otitbridge/snes-controller-uiapduino/docs/development/README.md

# 開発記録

ここでは試行履歴・原因調査・作業引き継ぎを扱います。導入や通常使用は [利用者向け資料](../publication.md) を参照してください。

## 開発中の追加機能（2026-11-12）

`feature/select-boot-keymap` で起動時SELECTによるTab／Backspace切り替えを実装しました。[動作仕様](../sfc-keyboard.md#起動時selectによる切り替え開発版)と[ビルド結果](../build.md#開発ブランチの追加機能)を参照してください。2026-11-13に実機書き込みと読み戻し検証を完了し、ユーザーから動作に問題なしとの報告を受けました。公開済みv1.0.0は変更していません。

## 保存した履歴

2026-11-10、公開資料と備忘メモを分けるため、コミット `7de5b1e` 時点の以下の文書を保存しました。本文は相対リンクの調整を除いて維持しています。「現在」「次工程」「未実施」は保存当時の表現で、最新状態の案内ではありません。

| 記録 | 内容 |
| --- | --- |
| [検証履歴](validation-history.md) | ホスト試験、書き込み、実機操作、再試験の時系列 |
| [問題調査の履歴](known-issues-history.md) | U04・D09・SELECT、原因候補、観測方法と判断の限界 |
| [統合版の履歴](sfc-keyboard-history.md) | 入力とUSBの統合、Mac／iPhone試験、ファーム切り替え |
| [ビルドの履歴](build-history.md) | 旧モードのサイズ、依存物照合、書き込み・取得方法 |
| [配線と診断の履歴](wiring-history.md) | 線色照合、誤配線訂正、未接続・実配線の診断結果 |

この編集は試験の再実施や不具合の修正ではありません。既存JSONと過去の文書ハッシュは当時の証跡として保持します。

## その他の開発資料

- [開発環境と参照元の来歴](../provenance.md)
- [最小HID試験の記録](../minimal-hid.md)
- [証跡JSONの索引](../evidence/README.md)
- [コアの管理パッチ](../../patches/README.md)
- [引き継ぎ仕様と作業計画](../../SNES_UIAPduino_CODEX_HANDOFF.md)

## 作業再開時の前提

| 項目 | 現在の状態・参照先 |
| --- | --- |
| 通常版 | SELECT→Tabの `sfc-keyboard`。BINの識別は [ビルド資料](../build.md#成果物を確認する) |
| 内蔵構成 | 元ケーブルを撤去し、USB-Cケーブル接続状態で収納。入力・再接続・30分使用・握り込み・ケーブル軽操作は確認済み。[証跡](../evidence/enclosure-fit-2026-11-11.json) |
| iPad | Air（M2）／iPadOS 26.5／Delta 2.0.1で動作確認済み。[確認範囲](../validation.md#ipadでの確認) |
| U04・D09 | ユーザー裁定で未解決のまま許容。追加の原因調査は次工程の前提にしない |
| Backspace | Delta 2.0.1でも再現報告あり。[Issue #579](https://github.com/rileytestut/Delta/issues/579) へ投稿済み。Tabを維持 |
| 残る試験 | SNES実ゲーム、Deltaでの6／7入力、SNESの右＋Y＋B部分解放。詳細は [未確認の範囲](../known-issues.md#未確認の範囲) |
| 写真 | [内部配置・完成外観](../hardware.md#内蔵用部材と写真) を収録済み |
| 未収録の資料 | SFC基板接続点の接写、施工寸法・固定方法、電気的な実測、再書き込みアクセスの確認 |

通常版の合意した試験範囲は完了しています。内蔵後とiPadの個別試験条件が未記録の部分は、過去の測定値や別端末の条件で補完しません。Backspace再現試験とiPad動作確認も別の報告です。

## 追加の調査

- [Delta 2.0.1のBackspace入力調査](delta-keyboard-review.md)：公開ソース比較と再現報告。1.7.3の詳細比較・2.0.1の追加報告・原因仮説を区別しています。
- [USBケーブル直付けと代替CH32ボード](usb-direct-wiring.md)：D+／D−の引き出し、回路図の参照先、移植・加工時の確認点。

公開操作はユーザーの指示に従います。文書更新・ローカルコミット・push・リリースはそれぞれ別の作業として扱います。
