otitbridge/snes-controller-uiapduino/SNES_UIAPduino_CODEX_HANDOFF.md

# SFCコントローラー内蔵UIAPduino版 — Codex引き継ぎ・実装検証計画

- 作成日：2026-11-10（日本時間）
- 所有者：otitbridge
- 文書の位置づけ：実装前の引き継ぎ仕様・検証計画。完成版READMEではない。
- リポジトリ：<https://github.com/otitbridge/snes-controller-uiapduino>
- 既存プロジェクト：<https://github.com/otitbridge/snes-controller-m5stick-s3>

> **今回の開発は、すでに動作しているM5StickS3版の小型化・コントローラー内蔵化である。**
> SFC入力読み取りとHIDキー変換を再利用し、USB実装をUIAPduino／CH32V003向けに置き換える。
> M5StickS3版の成功は、UIAPduino版の成功を保証するものではない。ソフトウェアUSB、電圧、ピン、接続・復帰処理は移植先で検証する。

> 本文には実装開始時の計画・初期状態を残しています。作業を再開する際は [開発記録の現在状態](docs/development/README.md#作業再開時の前提)、[検証結果](docs/validation.md)、[既知の問題](docs/known-issues.md) を先に確認してください。「最初に実行すること」や初期試験表を、完了済み作業の再実施指示として扱わないでください。

## 0. Codexが最初に実行すること

2026-11-11追記：[USB HID・DirectInput・XInputの公開実装調査](docs/development/gamepad-windows-research.md) をmainの開発資料に保存しました。キーボード版を合意した確認範囲での完成品として維持し、`feature/usb-gamepad` の実験は保留を継続します。Windows 11での試験は未実施で、以下の初期計画をゲームパッド開発の再開指示として扱わないでください。

1. この文書を読み、作業ディレクトリ、既存ファイル、Gitの変更状態、利用可能なビルド環境を確認する。
2. 既存M5StickS3リポジトリと本書の参照コミットを読み取り専用の比較対象として確認する。既存版をUIAPduino用に上書きしない。
3. 新規作業領域で、SFC入力・HIDレポート生成・USBバックエンドを分離した最小構成を用意する。
4. 最初はホスト上の純粋ロジックテストと最小HIDファームウェアのビルドまで進める。ボードの型番・接続対象・書き込み手段が未確認なら、実機への書き込みは行わない。
5. 実機検証の結果が得られたら、本書の検証表を転記した記録に「条件・手順・結果・証拠」を追記する。

**すでに決まっている方針を再質問しないこと。** 不明なピンや機種は未確定として設定・記録に分離し、その情報がなくてもできるコード整理とテストを先に進める。ただし、通電・書き込みに必要な情報を推測で埋めない。

## 1. ゴールと利用シーン

```text
SFC／SNES純正コントローラーのボタン
    ↓ 既存コントローラー基板のシリアル出力
筐体内に収納したUIAPduino開発ボード（CH32V003）
    ↓ USB HIDキーボード／有線USB-C
USB-C搭載iPhoneまたはiPad
    ↓ キー割り当て
Delta
    ↓
レトロゲームの操作
```

利用時にPC、外付け変換器、Bluetoothペアリングを必要としない構成を目指す。開発・書き込み・診断のためのPC使用は問題ない。

完成後はGitHubとProtoPediaで公開し、ニコニコ技術部系の展示会で体験展示する予定。訴求点は「純正の操作感・外観をできるだけ維持し、小型開発ボードを内蔵してiPhone／iPadへ有線接続する」こと。世界初などの新規性は未検証であり、主張しない。

## 2. 確認済み事実と未検証事項

### 2.1 ユーザー本人が確認・決定していること

| 項目 | 状態・意味 |
| --- | --- |
| M5StickS3版は本人のプロジェクト | `otitbridge/snes-controller-m5stick-s3` |
| M5StickS3 → USB-C有線 → iPhone 17 → Delta | 本人が実機動作確認済みと報告している |
| UIAPduino開発ボードの筐体収納 | 開発ボードをそのままSFCコントローラー内に完全収納し、配線する具体的な算段がある |
| 検証の順番 | 筐体内へ組み込む前に、ブレッドボードで長押し・同時押し等を確認する |
| 今後の開発 | Codexへ引き継いで実装・検証する |
| 公開先 | GitHub、ProtoPedia |
| 所有UIAPduinoの版数 | V1.4（2026-11-10、本人申告） |
| 所有UIAPduinoの電圧設定 | 5V、初期状態（2026-11-10、本人申告。実測値ではない） |

「収納の算段がある」は「内蔵完成品が動作確認済み」と同義ではない。外付けアダプター方式へ方針を戻す必要はない。

### 2.2 既存リポジトリから確認できること

既存READMEには、iPhone 17／iOS 26.6.2／Delta 1.7.3sで、USB接続したM5StickS3が外付けキーボードとして認識された記録がある。日付は2026-10-12。これは既存版の記録であり、新版の検証結果ではない。[S1]

コードには、SFCの16ビット読み取り、12ボタンのビットマスク化、6キーのHIDレポート生成、接続時の状態同期・送信失敗時の再試行、およびそれらのホスト上の回帰テストがある。[S2][S3][S4]

### 2.3 まだ確認されていないこと

- UIAPduino版でのSNES実ゲームの全12入力。SNESのキー配置画面は旧版で全12入力を確認済み。iPad Air（M2）／iPadOS 26.5／Delta 2.0.1でも動作確認済みとの本人報告があり、個別試験条件は未記録。iPhone 17／iOS 26.2／Delta 1.7.3のGBA『シナモンふわふわ大作戦』では、10入力登録とゲームで使う操作の成功を本人が報告済み。USB列挙の詳細は取得していない。
- UIAPduino版のUSBキーボード出力での短押し保証、起動時保持、再接続・復帰の安定性。Macでは全12ボタン・左右の30秒以上の保持・同時押し・部分解放・6→7→6入力の復帰を確認済み。iPhone／DeltaのGBAでは全解放での再接続10回・USB-Cの向き4組・抜去中の右解放は本人報告で成功したが、接続前から保持した右は押し直しが必要でU04は未合格。U04・D09は未解決のまま許容するユーザー裁定があり、追加調査を作業継続の条件にはしない。
- 所有するUIAPduinoの正式な製品型番、実測VDD、ブートローダ全体の照合。版数V1.4・電圧設定5V（初期状態）は本人申告済み。導入コア1.2.15とブートローダ記述子1.41はP2で確認済み。
- 使用するSFCコントローラーの型番・基板版、実測電源と信号波形。既存版と同じ個体で、基板番号・線色・5信号の対応は本人申告済み（`docs/wiring.md`）。実配線修正後の入力診断は確認済み。写真・導通の元記録は未保存。
- 検証用iPadの個別試験条件。機種はiPad Air（M2）、OSはiPadOS 26.5、Deltaは2.0.1と報告済み。iPhoneの全試験結果をiPadへ転用しない。
- 内蔵の施工詳細、発熱の個別結果。内蔵後の30分連続使用、握り込み・ケーブル軽操作時の安定性は本人報告で問題なし。絶縁・固定・挟み込み・干渉、閉蓋後の操作感、入力・接続確認は本人報告で問題なし。

**この文書の作成時には、UIAPduino用ファームウェアのビルド、書き込み、実機試験は行っていない。** 過去の会話で紹介された第三者のiPhone接続事例は補助情報にとどめ、このプロジェクトの合格証拠にしない。

## 3. 今回の範囲

### 必須

- UIAPduino開発ボードを使用し、SFCコントローラー筐体へ内蔵する。
- 既存コントローラー基板のCLOCK／LATCH／DATA方式を使う。
- USB HIDの**キーボード**として動作させる。USBゲームパッド化は初期目標にしない。
- 十字キー、A／B／X／Y、L／R、START／SELECTの12入力を読み取る。
- 初期版では既存M5StickS3版と同じキー割り当て・6キー同時押し方針を採用する。
- キーの押下状態を保持し、離したキーを確実に解放する。
- iPhone 17を優先して検証し、iPadは端末別に追加検証する。
- 再現可能なビルド方法、配線、書き込み方法、検証条件を記録する。

### 初期版では対象外

BLE、Wi-Fi、LCD、Webモニター、Webゲーム、OTA、マクロ・連射、NKRO化、独自PCB設計、汎用設定アプリ、他機種コントローラー対応。

既存のGBA Dumperとの展示連携は将来の演出案であり、本件の実装依存にはしない。

## 4. 参照ソースと固定点

2026-11-10に確認した参照先は以下。再現性のため、`main`だけでなくコミットSHAを記録する。

| 対象 | 参照点 | 用途 |
| --- | --- | --- |
| 既存M5StickS3版 | `21b7ba91c6428b25d7b7ab116052443a9aced965` | 入力読み取り・キー変換・テスト・既存実績 |
| `tarosay/arduino_core_ch32` | `9471a150c9837c9055ef62ef759a1a593eddf1b1` | UIAPduino向けArduinoコア候補の実装確認 |
| `tarosay/board_manager_files`のパッケージ索引 | 確認時に`UIAP_HID:ch32v`の`1.2.15`が掲載 | 導入候補。実際の導入版・取得物を記録する |
| UIAP公式V1.4ページ | 作成日に確認した公開資料 | 電圧、ボード仕様、回路資料への入口 |

`tarosay`のコアは採用候補であり、メーカーが提供するすべての環境と同一ではない。別forkのピン番号、API、USB設定を混在させない。パッケージ版と確認済みGitコミットの同一性も、実装開始時に照合する。[S5][S6][S7][S10]

## 5. 再利用する部分・置き換える部分

| 既存資産 | 方針 |
| --- | --- |
| `src/main.cpp`の`readController()` | 読み取り順・極性・タイミングを参照して切り出す。GPIOと環境依存部分を変更 |
| 12ボタンのビット定義 | 維持 |
| `src/keyboard_state.h`の`Report`と`makeReport()` | 優先して再利用。名前空間は衝突回避のため変更推奨 |
| 同ファイルの`State` | 設計意図とテスト観点を再利用。USB送信契約が違うため無条件に流用しない |
| `tests/usb-keyboard-state.test.cpp` | 既存挙動の仕様資料として利用。純粋レポート生成と移植先USBのテストを分離 |
| `USB.h`、`USBHIDKeyboard.h`、TinyUSB呼び出し | UIAPduino用バックエンドへ置換 |
| ESP32のUSBイベント、`std::atomic`、タスク前提 | 移植先のイベント・割り込み設計に置換 |
| M5Unified、LCD、BLE、Wi-Fi、Web機能 | 新版には持ち込まない |
| `platformio.ini` | ESP32用設定をコピーしない。新しい環境で独立して定義する |

根拠：既存コードとテスト。[S2][S3][S4]

## 6. 入力仕様・キー割り当て

### 6.1 ビットマスク

内部状態は`uint16_t`の下位12ビットを使用し、`1 = 押下`とする。SFCのDATA信号ではLOWが押下であり、読み取り時に内部表現へ変換する。[S2]

| bit | SFCボタン | キー | Raw HID Usage ID |
| ---: | --- | --- | --- |
| 0 | B | Z | `0x1D` |
| 1 | Y | A | `0x04` |
| 2 | SELECT | Tab | `0x2B` |
| 3 | START | Enter | `0x28` |
| 4 | UP | 上矢印 | `0x52` |
| 5 | DOWN | 下矢印 | `0x51` |
| 6 | LEFT | 左矢印 | `0x50` |
| 7 | RIGHT | 右矢印 | `0x4F` |
| 8 | A | X | `0x1B` |
| 9 | X | S | `0x16` |
| 10 | L | Q | `0x14` |
| 11 | R | W | `0x1A` |

表の英字はキーの名称であり、大文字入力のためのShiftを追加する意味ではない。初期版の修飾キーバイトは常に0とする。Raw HID Usage IDと、ASCIIコードやArduinoの`KEY_*`定数は区別する。[S3][S8]

SELECTはP4のDelta 1.7.3でBackspaceが割り当て画面に受け付けられない問題への対処候補として、ソースをTabへ変更しました。旧版はBackspace（`0x2A`）です。22:19に候補を書き込み、読み戻し・起動を確認しました。MacのTab押下・解放とDeltaのTab登録・GBA動作は確認済みで、現在搭載中のBINはP4証跡の `current_device_firmware` を参照してください。使用する各システムのDeltaキーレイアウトでSELECTをTabへ設定します。GBAでは再割り当てと動作確認が完了しています。

### 6.2 レポート生成

- `modifiers` 1バイト、`reserved` 1バイト、`keys[6]`で8バイト。
- `reserved = 0`。未使用キー枠は0で埋める。
- 押下中の全ボタン状態から、その時点のレポートを作る。
- 7キー以上なら、上記bit順の先頭6キーを採用する。
- 6キー以内へ戻ったときは、まだ押されているキーを再計算して反映する。
- 初期版で7キー以上を完全に扱えるとは宣伝しない。12入力の読み取り対応と6キー同時出力は別である。

これは既存版の仕様を維持するための選択であり、USBキーボード全般の最大値を意味しない。[S3]

### 6.3 SFC読み取りの初期基準

既存版は、CLOCKをHIGHにし、LATCHをHIGHで12µs保持、LOWにして6µs待機した後、最初のビットを読み取る。その後、CLOCKのLOW／HIGHを各6µsとして計16ビットを読み、`0x0FFF`でマスクする。入力ポーリングは約10ms間隔。[S2]

初期移植ではこの挙動を基準にする。ただし、これは**既存コードの設定値**であり、移植先の実測値でも、ゲーム画面までの遅延でもない。USB割り込みによる波形の伸びや、`delayMicroseconds()`の実装差は必要に応じて測定する。

## 7. ハードウェア確認

### 7.1 ボードと電圧

所有ボードは**V1.4、電圧設定5V（初期状態）**と2026-11-10に本人から報告された。正式な製品型番と実測電圧は未確認。本書の具体的なピン候補は**UIAPduino Pro Micro CH32V003 V1.4**を想定しており、採用前に実物との対応を確認する。

メーカーのV1.4資料では、MCU電源は5Vが初期値で、3.3Vへの切り替えが可能。また、MCU電源の設定を変えても、3.3V出力ピンと5V出力ピンの意味は変わらない。[S10]

初期試験ではMCUとSFCコントローラーの電圧系統を明確にし、可能なら同じ電圧に揃える。5V構成と3.3V構成のどちらを使うかは、実物の設定とコントローラーの動作を確認して決定する。既存M5StickS3版は3.3V給電だが、それを電源ピン名だけで移植しない。[S1]

通電前に次を確認する。

- MCUのVDD、コントローラーのVCC、CLOCK／LATCH／DATAの電圧整合。
- USB給電と外部給電を不用意に並列接続しない構成。
- 共通GNDと、電源・GND間の意図しない短絡がないこと。
- ケーブル色だけで信号を断定せず、導通で接続点を特定したこと。
- M5StickS3とUIAPduinoで同じCLOCK／LATCHを同時に駆動しないこと。

### 7.2 ピンの予約と候補

確認したコアではPC4／PD2をUSB-CのCC制御に使用している。PD3／PD4もUSB用である。これらをSFC用GPIOに流用しない。PD1はSWIOに関係するため、初期版では復旧性のために避ける。[S6][S7]

| 用途 | MCUポート候補 | 確認したコアでのArduino番号 | 状態 |
| --- | --- | --- | --- |
| SFC CLOCK | PC5 | `GPIO_PIN_7` | P3診断版で採用、実配線後の入力を確認 |
| SFC LATCH | PC6 | `GPIO_PIN_8` | P3診断版で採用、実配線後の入力を確認 |
| SFC DATA | PC7 | `GPIO_PIN_9` | P3診断版で採用、実配線後の入力を確認 |

ポート対応はコアREADMEによる。[S5] 採用前に実際の`variants`、基板シルク、ピンの兼用機能を照合する。裸の整数値は物理ピン番号と混同しやすいため、設定にポート名も併記する。

SFC基板への電源・GND・3信号の接続点、採用電圧、ケーブル引き出し方法は`docs/wiring.md`に写真とともに記録する。USB配線を加工する場合はCC線とD+/D-を含めて確認し、既存コネクタ経路での成功と加工後の成功を分ける。

2026-11-10に本人から提示されたSFC基板の接続番号は、1＝茶/GND、2＝赤/DATA、3＝橙/LATCH、4＝黄/CLOCK、5＝白/VCC。この個体の本人申告として扱い、外部7ピンコネクターの番号やUIAPduinoの表示番号と区別する。対応表とネット上の資料との比較は `docs/wiring.md` に記録済み。同日に本人が実配線の相違を修正した後、全12ボタン・左右の長押し・同時押し・部分解放を診断で確認した。写真、導通・電圧の元記録は未保存。

### 7.3 内蔵時の確認

収納自体の算段はユーザーが済ませている。設計をやり直すのではなく、絶縁、固定、ケーブルの引張り対策、ボタン／ゴム接点／ねじとの干渉、書き込みモードへのアクセスを確認する。ブレッドボード版の合格後に内蔵し、内蔵後に再試験する。

## 8. ビルド環境の方針

第一候補は、確認した`tarosay/arduino_core_ch32`を使うArduino環境。USBモードは`Keyboard+Mouse`を基準にする。マウス機能は使用しないが、初回からディスクリプタを大幅に改造しない。[S5]

確認時のパッケージ索引には`UIAP_HID:ch32v`の`1.2.15`と、`HID ProMicro CH32V003`というボード名が掲載されている。[S7]

```text
追加ボードマネージャURL：
https://github.com/tarosay/board_manager_files/raw/main/package_uiap_hid_index.json
```

Codexはインストール済み環境を調べ、実際のFQBN、USBモードのオプション、アップロード方式を取得してからコマンドを確定する。存在を確認していないFQBNやシリアルポートを推測して書き込まない。

記録対象：OS／CPU、Arduino IDEまたはCLIの版、コアの版、ソースSHA、ツールチェーン、ビルドオプション、USBモード、使用アップローダ、バイナリサイズ、Flash／RAM使用量、ブートローダを除いた利用可能領域。

CH32V003の公称Flash 16KB／RAM 2KBを、アプリが無条件で全量使えるという意味にしない。ブートローダ予約領域、スタック、USB内部バッファを含む実際のビルド結果を確認する。[S5]

既存版がPlatformIOだからという理由で、初回からPlatformIO対応を優先しない。必要なら最小ファームの成功後に追加する。ch32fun／rv003usbの直接利用は代替案とし、初回から複数のUSB実装を並行開発しない。

## 9. USB実装で必ず扱う注意点

### 9.1 バッファ更新と送信成功は別

確認した`uiapkbd_keyboard_set()`は、8バイトのキーボード状態バッファを書き換える`void`関数である。USBのIN要求を扱う割り込み側が、そのバッファを参照して送信する。[S6]

一方、既存`Keyboard::State::update()`は、渡された送信関数の`true`を受けて、送信済み状態や同期状態を進める設計である。[S3]

**したがって、setterを呼んだ直後に無条件で`true`を返すだけでは、既存Stateの送信契約を維持できない。** また、送信APIの成功が何を意味するかは、キュー投入・転送完了・ホスト受信を区別して確認する。どの段階もDeltaのゲーム操作反映とは別である。

最小試作は「最新レポートを保持する」方式でよい。ただし、復帰時のニュートラルレポートや短押しを保証するには、ホストが取得する前の上書き、接続状態、送信タイミングを別途扱う。

`desired`（現在必要な状態）、`staged`（USB側へ渡した状態）、`transferred`（確認できる範囲の転送状態）など、変数名にも意味を分ける。観測できない完了状態を推測で作らない。

### 9.2 `Keyboard`という名前の衝突

既存ヘッダは`namespace Keyboard`を定義する。UIAPduino側の`Keyboard.h`はグローバルな`Keyboard`オブジェクトを宣言するため、両者を同じ名前のまま同一翻訳単位へ持ち込むと衝突する。[S3][S8]

推奨する回避策：移植する純粋ロジックの名前空間を`SnesHid`等へ変更し、USBバックエンドでは必要な`uiapusb.h`だけを使用する。`Keyboard.h`が実際に必要なときだけ追加する。

### 9.3 まずは状態全体からレポートを生成する

長押しを`Keyboard.write()`の繰り返しで実現しない。確認した実装では`write()`は押下・待機・全解放・待機を行い、既存の保持キーもクリアするため、ゲーム操作の長押し・同時押し用途にはそのまま使えない。[S9]

また、確認した`press()`には同じキーの登録済みチェックが見当たらず、押されている間に毎ループ呼ぶと同じキーで枠を埋める可能性がある。[S9]

既存の`makeReport()`を基に、現在の12ビット状態から一つのレポートを作る方式を優先する。毎回「全解放 → 押下」を送る実装も避け、保持中のキーを不必要に離さない。

### 9.4 共有バッファの整合性は検証対象

確認したコアではメイン側が`volatile`のバッファを1バイトずつ更新し、USB割り込み側が同じバッファを参照する。setter内に、8バイト全体を一括で公開する仕組みは見当たらない。[S6]

**解析上の懸念：更新途中に割り込みが入ると、新旧状態が混じる可能性がある。** これは今回実機で確認した不具合ではない。必要に応じて二重バッファと短い公開操作等を検討し、採用実装と割り込み処理を追って確かめる。

USBがソフトウェア処理であるため、対策として長い割り込み禁止区間を安易に作らない。特にSFCの16ビット読み取り全体を`noInterrupts()`で囲まない。コア側を変更する場合はパッチを管理し、導入済みパッケージを黙って手編集しない。

P3の `sfc-keyboard` では専用コピーへ管理パッチを適用し、2つの8バイト配列と1バイトの公開索引で完成状態を公開する実装を追加した。元コアは保持し、ホストの割り込みモデルで混在の再現・解消を確認した。割り込み禁止は追加していない。実装・前提は `patches/README.md`、実施状態は `docs/sfc-keyboard.md` を参照する。転送完了や短押し保持の保証とは区別する。P4ではGET_REPORT(Input)応答を加えた候補を検査・書き込みしたが、Macの接続時保持は物理保持中にkeyupとなり、U04は未合格のまま。基板のキーボード状態とホストイベントを切り分ける。

### 9.5 短押しと復帰は、単なる最終状態確認では不十分

ホストが次に取得する前に「押す → 離す」が発生すると、最終状態だけのバッファでは押下を取りこぼす可能性がある。また、ニュートラルを設定して直後に押下状態へ上書きすると、ホストがニュートラルを受け取ったとは限らない。[S6]

初期版は最新状態方式で動かし、実際の操作で短押しと復帰を測定する。問題が出た場合に、必要な状態遷移の保持や送信完了に対応した処理を追加する。無制限のイベントキューや固定の長い待機で隠蔽しない。キューを使うなら、満杯時の方針と「解放を失わない」条件を定義する。

### 9.6 Report ID・USBモード・割り込み

既存M5StickS3版のReport IDを、UIAPduinoの8バイトデータへそのまま付け足さない。採用するディスクリプタと送信関数の形式に合わせる。確認したコアのキーボード経路は8バイトを送っている。[S2][S6]

`WebHID Only`は標準キーボード出力と同じではない。Keyboard用APIが使えるビルドモードを選択する。[S5]

コアにはUSBのタイミングを守るためSysTick割り込みを使わない実装上の説明がある。汎用タイマー割り込みや別ライブラリの割り込みを追加する際は、USB動作への影響を確認する。[S6]

### 9.7 移植の概念例 — 完成ファームウェアではない

```cpp
// SnesHid::Report / makeReport() は既存ロジックを改名して切り出す想定。
// GPIO初期化、USB初期化、接続・復帰管理、共有バッファ対策は別途必要。
#include <uiapusb.h>
#include "snes_hid_report.h"

#ifndef UIAP_COMPOSITE_HID
#error "Select a UIAPduino USB mode that supports keyboard reports."
#endif

void stageKeyboardState(uint16_t buttons) {
    const auto r = SnesHid::makeReport(buttons & 0x0FFFu);
    uiapkbd_keyboard_set(
        r.modifiers,
        r.keys[0], r.keys[1], r.keys[2],
        r.keys[3], r.keys[4], r.keys[5]);
    // バッファ更新のみ。ここを「ホストへの送信完了」とみなさない。
}
```

この例は本書ではビルド・実機検証していない。APIの存在は確認済みだが、アプリ全体の正しさやUSB互換性を保証するものではない。[S6]

## 10. 推奨するコード構成

以下は論理的な分割案。Arduinoのスケッチ配置等は、実際にビルド可能な構造へ合わせる。

```text
snes-controller-uiapduino/
├── README.md
├── AGENTS.md                     # 確認済み実績と未確認事項を混同しない等の作業規約
├── LICENSE
├── firmware/
│   └── snes_controller/
│       ├── snes_controller.ino   # 初期化・読み取り周期・USB更新
│       ├── board_config.h        # 採用ピン・電圧条件・ポーリング設定
│       ├── snes_reader.h
│       ├── snes_reader.cpp       # CLOCK/LATCH/DATA、16bit→12bit
│       ├── snes_hid_report.h     # MCU非依存の純粋変換
│       ├── usb_backend.h
│       └── usb_backend.cpp      # uiapusb依存部、同期・復帰
├── tests/
│   ├── hid_report_test.cpp
│   └── usb_state_test.cpp        # 実際に採用した送信契約に対応
├── docs/
│   ├── build.md
│   ├── wiring.md
│   ├── validation.md
│   ├── known-issues.md
│   └── provenance.md            # 元ソース・SHA・コア版・変更点
└── patches/                     # コア変更が必要な場合のみ
```

Flash／RAMを節約し、動的確保や不要な大規模ライブラリを避ける。ただし、根拠のない最適化より、まず最小構成の計測と動作確認を優先する。

## 11. 実装と検証の順番

### P0. 既存成果と環境を固定する

作業ツリーを確認し、元リポジトリ、採用コア、ビルド環境を記録する。既存M5StickS3版は比較用の正常系として残す。実物のボード情報と電圧がない場合は未確定欄を残す。

**成果物：** `docs/provenance.md`、環境情報、未確定事項一覧。

### P1. 純粋ロジックを切り出す

ビット定義とHIDレポート生成を移植し、名前空間を整理する。ホスト上で全12ボタンの単独入力、長押し状態の不変性、部分解放、6キー上限と復帰をテストする。可能なら全4096通りの12ビット入力を網羅する。

**合格条件：** 正しいUsage ID、0の予約領域・未使用枠、キー重複なし、決定的な6キー選択。USBやMCUヘッダなしでテストできること。

### P2. UIAPduino単体の最小HIDをビルド・検証する

SFC読み取りをまだ入れず、安全な試験入力から一つのキーと解放を出す最小ファームを用意する。PCの入力テスト画面で確認してから、iPhone 17のDeltaで割り当てを確認する。

自動入力でシェル等を誤操作しないようにし、初期値は全解放とする。実機が使えない環境では、ビルドまでとし、実機確認を待つ項目を明記する。

**合格条件：** ビルド成功、サイズ確認、対象ボードへの書き込み成功、USB列挙、単キーの押下・保持・解放。ビルド成功と実機合格を分けて記録する。

### P3. SFC読み取りを統合してブレッドボード試験する

確認した電圧・ピンで接続し、まず入力ビットマスクが正しいことを診断する。その後HID出力へ接続する。シリアル診断が使えるとは決めつけず、必要に応じて別UART等を使用する。デバッグ出力の負荷にも注意する。

**合格条件：** 全12入力の対応が正しい。長押し・同時押し・部分解放が正常で、押しっぱなしが残らない。

### P4. iPhone／iPadとDeltaで実用試験する

下記検証表を端末・OS・Delta版ごとに実施する。M5StickS3版と同じコントローラー、端末、ケーブル、ゲームを可能な範囲で使い、基板だけの違いを比較する。

**合格条件：** 初回列挙だけでなく、再接続、アプリ切り替え、スリープ復帰後も操作可能。未実施の端末や条件は未確認のまま記載する。

### P5. 内蔵して再試験する

確定した配線を筐体へ移し、固定・絶縁・干渉・ケーブル応力を確認する。閉じた状態でP3・P4の主要試験を繰り返す。

**合格条件：** 開閉や握り込みで接触不良が発生せず、各ボタンの操作感とUSB接続が安定する。

### P6. 公開用の資料を整備する

配線写真、内部写真、部品表、ビルド・書き込み方法、対応環境、制限をまとめる。GitHub向けは再現性を、ProtoPedia向けは操作体験と旧版からの小型化を説明する。

**合格条件：** 別の人が、同じボード・コア・条件で再現を試みられること。公開物に商用ROMや個人情報を同梱しない。依存物のライセンス表記を保持する。

## 12. 検証マトリクス

以下は**提案する試験条件**であり、実施済みの結果ではない。秒数・回数はプロジェクトの初期合格基準であり、公式規格の値ではない。

実施後の状態と証拠は `docs/validation.md` に記録する。2026-11-10のP1でL01～L03はPC上のテストに合格した。以下の表は当初の計画として保持する。

同日のP2で全キー解放版と手動単キー版の書き込み・読み戻し検証、MacでのU01（キーボード列挙）と、ジャンパ線による単キーの押下・保持・解放（6.084秒、6.121秒、30.908秒）に合格した。続くP3で実配線後の入力診断を行い、共有キーボード状態の公開を整備した統合版を書き込んだ。Macでは全12キー、左43.089秒／右36.649秒の保持、同時押し・部分解放と6→7→6入力の復帰5回を確認した。P4ではiPhone 17／iOS 26.2／Delta 1.7.3のGBAゲームでB操作3回の成功を本人が報告し、GBAでの継続を希望した。以下のSNESを含む端末別試験の初期計画は保持し、現在の実施結果は `docs/validation.md` とP4記録へ分けて残す。

| ID | 試験 | 手順・観察点 | 合格条件 | 初期状態 |
| --- | --- | --- | --- | --- |
| L01 | 全キー変換 | 12ボタンを各1入力 | 表のUsage IDと一致 | 未実施 |
| L02 | 全入力組み合わせ | 0～4095のビットマスク | 選択順・0埋め・6キー上限が正しい | 未実施 |
| L03 | 上限からの復帰 | 7キー→6キー以下 | 除外されていた保持キーが現れる | 未実施 |
| H01 | 通電前確認 | 版数、VDD、VCC、導通、短絡 | 配線記録と整合、危険な接続なし | 未実施 |
| U01 | PCでUSB列挙 | データ対応ケーブルで接続 | キーボードとして認識 | 未実施 |
| U02 | USB-C直結 | iPhone 17で接続・抜き差し10回 | 再認識し、入力可能 | 未実施 |
| U03 | USB-Cの向き | 端末側／基板側の反転組み合わせ | 向きで成否が変わらない | 未実施 |
| U04 | 起動時保持 | 方向キーを押したまま接続 | 仕様通り現在状態へ同期し、離すと止まる | 未実施 |
| D01 | 全12操作 | Deltaで個別に割り当て・操作 | 意図した操作になる | 未実施 |
| D02 | 方向長押し | 左右それぞれ30秒保持 | 途中で切れず、離すと止まる | 未実施 |
| D03 | 複数同時押し | 斜め＋B＋Y等 | 全入力が意図通り反映される | 未実施 |
| D04 | 部分解放 | 右＋Y＋BからBだけを離す | 右とYが保持される | 未実施 |
| D05 | 6キー・7キー | 右＋B＋Y＋A＋L＋R、さらにSTART | 6キー時正常、7キー時は定義した選択順、復帰後正常 | 未実施 |
| D06 | 短押し・連打 | 単キーと、方向保持中の別キー | 観測した条件で欠落・固着なし | 未実施 |
| D07 | 抜去中の状態変更 | 保持中に抜き、離して再接続 | 古いキーが残らない | 未実施 |
| D08 | アプリ切り替え | Delta→他アプリ→Delta | 再割り当てなしで復帰、固着なし | 未実施 |
| D09 | スリープ・復帰 | ロック→解除、保持あり／なし | 実際の給電・接続状態を記録し、復帰後正常 | 未実施 |
| D10 | 連続使用 | 30分操作 | 切断、再起動、キー固着なし | PASS（本人報告: GBAを30分ちょうど、異常・警告なし。計測版初版、Delta前面・ロックなし） |
| I01 | iPad | 型番・OSを記録してU/D試験を再実施 | 端末別に判定 | iPad Air（M2）／iPadOS 26.5／Delta 2.0.1で動作確認済み（本人報告）。U/D各項目の結果は未記録 |
| M01 | 内蔵後 | 閉蓋し、握り・ケーブル軽操作・主要試験 | 干渉、接触不良、異常発熱なし | 機械・入力・再接続確認は本人報告で問題なし。30分使用・握り込み・ケーブル軽操作も問題なし。発熱の個別結果は未記録 |

D05の7キー例では、既存bit順を維持するとRが出力枠から外れ、STARTを離すとRが復帰する。ゲームが6操作を視覚的に区別できない場合は、PCの入力表示等でHID状態を確認し、Deltaでのゲーム操作試験とは分ける。

短押しの最小時間やエンドツーエンド遅延は、この時点では数値を約束しない。必要ならロジックアナライザや動画等で測定条件を定義し、入力サンプリング周期・USBの取得周期・画面反映を分けて記録する。

## 13. 不具合の切り分け順序

| 症状 | 優先して確認する対象 |
| --- | --- |
| 電源が入らない／向きで変わる | ケーブル、給電、CC、基板設定、加工箇所 |
| 給電するがUSB認識しない | USBモード、USB初期化、ディスクリプタ、割り込み競合 |
| PCでは認識するがiPhoneでは認識しない | 同じケーブルでの基準機比較、端末状態、USB構成・電源条件 |
| キーボード認識するがDeltaで使えない | Deltaのプレイヤー設定・キー割り当て、実際のHID Usage ID |
| ボタンとキーがずれる | SFCシリアル順、アクティブLOW、ピン番号、読み取りタイミング |
| 同時押しだけ不安定 | 逐次press処理、6キー上限、部分解放、共有バッファ |
| 短押しだけ抜ける | 入力サンプリング、ホスト取得前の上書き、ブロッキング処理 |
| 抜き差し・復帰後に固着する | 最新状態と送信状態の扱い、リセット／再列挙／サスペンドの区別 |
| 内蔵後だけ不安定 | 絶縁、応力、ケーブル経路、接点、GND、物理干渉 |

同時に複数層を変更せず、再現条件を固定する。M5StickS3版が使える場合は正常系として比較するが、二つのマイコンを同じSFC出力線へ同時接続して比較しない。

## 14. 検証記録テンプレート

`docs/validation.md`には、試験ごとに次の内容を残す。空欄は「未確認」とし、推測で埋めない。

```markdown
### 試験ID・名称
- 日時：
- 実施者：
- 状態：未実施 / ビルドのみ / PASS / FAIL / BLOCKED
- ファームウェアのコミットSHA：
- バイナリ名・SHA-256：
- コアの版・参照SHA・適用パッチ：
- ビルド環境・FQBN・USBモード：
- Flash／RAM使用量：
- UIAPduino型番・版数・MCU電源設定：
- SFCコントローラー型番・基板版・電源：
- CLOCK／LATCH／DATAのポート：
- ホスト機種・OS：
- Deltaの版：
- ケーブル／変換器／USB接続経路：
- 試験手順・操作時間・反復回数：
- 期待結果：
- 実際の結果：
- 証拠：ログ / 写真 / 動画 / 入力レポート / 本人の観察報告
- 未確認の範囲：
- 次の切り分け：
```

ユーザーが報告した実機結果は「本人の実機確認」として記録できる。Codex自身が観測したログと混同しない。端末を操作できない環境で、操作したように記述しない。

## 15. Codexの作業規約

- ソースで確認した事実、ユーザーの実機報告、設計上の推論、未検証の仮説を分ける。
- 既存M5StickS3版のREADMEや成果物を、UIAPduino版の変更で壊さない。
- 新規作業領域への実装とテストを優先する。リモートリポジトリ作成、push、公開リリースは別途ユーザーの指示に従う。
- 手元の変更を勝手に破棄しない。破壊的Git操作、ブートローダ消去、全面書き込み、デバイスの誤選択を避ける。
- 書き込み先は実物と対応づけて確認する。既存ボードのブートローダ領域と復旧手順を理解する前に低レベル書き込みを行わない。
- 「コンパイル済み」「PCテスト済み」「iPhoneのDeltaで実機確認済み」を別の状態として扱う。
- 低レベルAPIの戻り値、共有バッファ、USB割り込み、Report IDの意味を確認し、API名だけで互換と判断しない。
- 未確認のUSBイベント通知APIやFQBNを発明しない。利用できない場合は制約として明記する。
- コア修正は再現できるパッチやforkとして記録する。必要性を確認せずにUSBスタック全体を書き直さない。
- 各段階の終了時に、変更ファイル、実行したコマンド、結果、未実施事項、次の手順を短く報告する。
- ライセンス表記を保持する。自作ソースのライセンスと、コア・USBスタック等の依存物のライセンスを混同しない。

## 16. 初回セッションの到達目標

初回は以下を目標とする。実機を扱える状態であることが確認できていなければ、ビルド・テストまでで区切る。

- [x] 既存版とコアのソース、環境、作業ツリーを確認した（2026-11-10、P0。記録は `docs/provenance.md`）。続くP2でコア導入・CLI照合・最小ファームのビルドまで実施。
- [x] 移植対象・非対象・未確定ピンを文書化した（`docs/provenance.md`）。
- [x] `SnesHid`等へ分離したレポート生成を実装した（2026-11-10、P1）。
- [x] ホスト上の単体テストを実行し、結果を残した（2026-11-10、L01～L03 PASS。`docs/validation.md`）。
- [x] UIAPduino単体の最小HIDファームを用意した（2026-11-10、P2。全解放版・手動単キー版を書き込み、MacでUSB列挙と手動単キー版の押下・保持・解放を確認。iPhone／Deltaは本人の希望で後日確認）。
- [x] 実際のビルド設定とサイズを記録した（`docs/build.md`、`docs/evidence/p2-build-2026-11-10.json`）。
- [x] 次に行うブレッドボード試験の配線と操作手順を示した（`docs/wiring.md`。本人申告のSFC基板番号・線色・信号と、UIAPduino側端子の対応を記載済み。同日に実配線修正後の全12入力・長押し・同時押し・部分解放を診断で確認）。

**最優先は「動く最小構成」と「実際に確認した範囲の明確化」である。多機能化や公開演出は、その後に行う。**

---

## 付録A. Codexへの開始指示（貼り付け用）

```text
SNES_UIAPduino_CODEX_HANDOFF.mdを読み、SFCコントローラー内蔵UIAPduino版の開発を開始してください。

既存の otitbridge/snes-controller-m5stick-s3 は、USB-C有線でiPhone 17とDeltaで動作確認済みです。
UIAPduino開発ボードをSFCコントローラー筐体にそのまま収めて配線する算段もついています。
ただしUIAPduino版の実機動作は未確認なので、まずブレッドボードで検証します。

既存M5StickS3版は変更せず、新規作業領域で進めてください。
まず環境とソースを確認し、SFC入力、HIDレポート生成、UIAPduino用USBバックエンドを分離してください。
初回は純粋ロジックのテストと最小HIDファームウェアのビルドを優先してください。

Keyboardの名前衝突、バッファ更新と送信完了の違い、共有バッファとUSB割り込み、CCピンの予約、電圧設定に注意してください。
未確定事項は未確定として分離し、既に決まっている方針を聞き直さず、可能な作業を進めてください。
実物・接続先・書き込み方式の確認なしに、フラッシュ消去や書き込みを実行しないでください。
ビルド成功、PC上のテスト、実機確認の結果は明確に区別してください。
```

## 付録B. 出典

ユーザーの方針・実績は2026-11-10の本会話による。以下はコード・技術仕様の参照先。GitHub参照は可能なものを確認済みコミットに固定している。

- [S1] [既存版 README](https://github.com/otitbridge/snes-controller-m5stick-s3/blob/21b7ba91c6428b25d7b7ab116052443a9aced965/README.md)
- [S2] [既存版 src/main.cpp](https://github.com/otitbridge/snes-controller-m5stick-s3/blob/21b7ba91c6428b25d7b7ab116052443a9aced965/src/main.cpp)
- [S3] [既存版 src/keyboard_state.h](https://github.com/otitbridge/snes-controller-m5stick-s3/blob/21b7ba91c6428b25d7b7ab116052443a9aced965/src/keyboard_state.h)
- [S4] [既存版 tests/usb-keyboard-state.test.cpp](https://github.com/otitbridge/snes-controller-m5stick-s3/blob/21b7ba91c6428b25d7b7ab116052443a9aced965/tests/usb-keyboard-state.test.cpp)
- [S5] [UIAPduino向けArduinoコア README](https://github.com/tarosay/arduino_core_ch32/blob/9471a150c9837c9055ef62ef759a1a593eddf1b1/README.md)
- [S6] [UIAPduino USB実装 uiapusb.c](https://github.com/tarosay/arduino_core_ch32/blob/9471a150c9837c9055ef62ef759a1a593eddf1b1/cores/arduino/uiapusb.c) / [uiapusb.h](https://github.com/tarosay/arduino_core_ch32/blob/9471a150c9837c9055ef62ef759a1a593eddf1b1/cores/arduino/uiapusb.h)
- [S7] [ボードマネージャ用パッケージ索引](https://github.com/tarosay/board_manager_files/blob/main/package_uiap_hid_index.json)（可変参照。確認時の索引blob SHA：`e00185e4e4efc578ee265b6b419e47f16e5fdbae`）
- [S8] [Keyboard.h](https://github.com/tarosay/arduino_core_ch32/blob/9471a150c9837c9055ef62ef759a1a593eddf1b1/libraries/Keyboard/src/Keyboard.h)
- [S9] [Keyboard.cpp](https://github.com/tarosay/arduino_core_ch32/blob/9471a150c9837c9055ef62ef759a1a593eddf1b1/libraries/Keyboard/src/Keyboard.cpp)
- [S10] [UIAP公式：UIAPduino Pro Micro CH32V003 V1.4](https://www.uiap.jp/uiapduino/pro-micro/ch32v003/v1dot4)

## 現在の再開点（2026-11-10）

現在の合否は [検証一覧](docs/validation.md)、試行履歴と識別情報は [P4証跡](docs/evidence/p4-iphone-delta-2026-11-10.json) を参照してください。上記の当初計画と、条件付きで進めた現在の到達点を区別します。

- 基板はSELECT→Tabの通常版 `sfc-keyboard`、BIN SHA-256 `43a82eb36c7df4d298dd01f6b25460117fab0207c9206382b5eeaf92379a9079`。22:19に書き込み・読み戻し・起動・Mac再列挙を確認しました。MacのTab押下・解放3回とBの対照、DeltaのTab登録と『シナモン』動作はPASS。同じTab版で斜め・3入力以上、右＋Bの部分解放、全解放での再接続3回も本人報告でPASS。工程2は今回の合意範囲で完了し、収集は停止済みです。
- trace v1でのD08アプリ切り替えとD09ロック解除は全解放条件で各3回PASS。D10は30分ちょうどのGBAプレイで異常・警告なし、本人報告でPASSです。
- U04・D09はユーザー裁定で未解決のまま許容し、追加調査を次工程の条件から外します。全解放で接続・ロックし、D09で右が残った場合はDelta前面で右を押し直して離します。原因未確定とFAIL条件は保持します。
- 現在のtraceビルドは未書き込みのtrace v2を生成します。SETUP応答前の履歴コピーに懸念があり、修正・確認まで使用保留です。
- Deltaの斜め・3入力以上は『シナモン』で、SNES全12入力はキーレイアウト設定画面で本人確認済みです。6／7キーとD04追加条件、SNES実ゲーム（ROM未所持で後日）の試験が残っています。iPad Air（M2）／iPadOS 26.5／Delta 2.0.1で動作確認済みとの本人報告を受領しました。個別試験条件は未記録です。内蔵後は2026-11-11の本人報告で機械・入力・再接続確認に問題なし、30分連続使用・握り込み・ケーブル軽操作も問題なし。詳細条件は未記録です。

- Backspace不応答はDelta 2.0.1でも再現したとの追加報告を受領し、[Delta Issue #579](https://github.com/rileytestut/Delta/issues/579) へotitbridgeから投稿済み。2.0.1再現試験の入力機器・OS詳細は未記録で、iPadの動作確認報告と同一条件とは推定しない。

### 現在の作業方針と残件

1. **完了**：通常版 `sfc-keyboard` へ書き込み・読み戻し・起動・MacのUSB/HID列挙を確認した。未書き込みのtrace v2は使っていない。
2. **今回の合意範囲で完了**：先行Backspace通常版でMacの全12キー・保持／部分解放・6→7→6入力、Tab通常版でMacのSELECT/BとiPhoneのGBA操作・同時押し・部分解放・再接続3回を確認した。Tab版でMac全項目を繰り返したという意味ではない。30分連続使用は後続の内蔵後確認で問題なしとの報告あり。Deltaで6／7入力を区別できない場合は、当初計画どおりPCの入力表示と分けて記録し、DeltaのD05を合格扱いにしない。SNES実ゲームはROMを用意できる時点へ繰り越す。
3. **P5内蔵後確認の報告あり（2026-11-11）**：内蔵用の別基板へ通常版を書き込み、ケーブルAT-PDCASTCC08を差した状態で内部へ収納。元のコントローラーケーブルは撤去済み。案内した絶縁・固定・挟み込み・干渉、閉蓋後の全12ボタンの操作感、全入力・長押し・同時押し・再接続は「問題無し」との本人報告を受領した。内蔵後の30分連続使用と握り込み・ケーブル軽操作時の安定性も問題なし。詳細な施工方法・試験条件と独立ログ、書き込みアクセスは未記録。従来の測定値を今回の結果として転用しない。
4. iPad Air（M2）／iPadOS 26.5／Delta 2.0.1で動作確認済み（本人報告）。iPadで使用したゲーム・個別試験条件は未記録で、iPhoneの全試験結果を転用しない。
5. **P6資料整理を先行**：README、[部品資料](docs/hardware.md)、[導入手順](docs/getting-started.md)、検証結果・既知制約を現在のTab通常版に合わせて整理した。内部配置・完成外観の写真は収録済み。SFC基板の接続点の接写と加工寸法は未収録。内蔵用基板の収納と組立後確認は本人報告として記録し、未記録の詳細条件を区別する。[公開資料の範囲](docs/publication.md) に残件と同梱範囲を記録し、リモート作成・push・公開リリースは別途指示に従う。

### 利用者向け資料と開発記録の分離

README、導入・部品・配線・ビルド・仕様・既知事項・検証結果は、利用者が読む現在の説明へ整理しました。工程番号・ユーザー裁定・試行経緯は [開発記録](docs/development/README.md) と本引き継ぎ文書で扱います。整理前の主要5文書は相対リンクを調整して保存し、証跡JSONは変更していません。P5は上記の内蔵後確認の報告まで更新しました。U04・D09未解決の許容と、未確認の端末・条件は従来どおりです。

## 内蔵写真の追加（2026-11-11）

ユーザー提供の内部配置・完成外観の写真を [部品資料](docs/hardware.md#内蔵用部材と写真) とREADMEへ掲載しました。以前の「写真未保存」は当時の状態です。写真ではUSB-C接続状態の収納と完成外観を確認できますが、SFC基板番号との照合、絶縁・固定強度、電気的な実測を追加確認したものではありません。識別情報は [写真の記録](docs/evidence/enclosure-photos-2026-11-11.json) を参照してください。
