otitbridge/snes-controller-uiapduino/docs/validation.md

# 動作確認結果

内蔵前の詳細試験、内蔵後の確認、iPadでの動作確認を対象ごとに記載します。接続時保持とロック中解放には [未解決の問題](known-issues.md) があり、SNES実ゲームは未確認です。

Mac・iPhoneの詳細試験は2026-11-10、内蔵後とiPadの確認報告は2026-11-11の記録です。Macの入力はブラウザイベント等のログで確認し、iPhoneのゲーム操作は実機操作者の観察報告に基づきます。iPhone側の独立したイベント記録や時間計測はありません。

## 確認環境

以下は2026-11-10の詳細試験の構成です。追加のiPad環境は [iPadでの確認](#ipadでの確認)、内蔵用の別基板は [内蔵後の確認](#内蔵用の別基板) を参照してください。

| 項目 | 内容 |
| --- | --- |
| マイコンボード | UIAPduino V1.4、初期5V設定 |
| コントローラー | 有線SFCコントローラー1台。型番・基板版は未記録 |
| 配線 | CLOCK＝7、LATCH＝8、DATA＝9、5V／GND |
| Mac | macOS 26.7.1 / Apple Silicon / Safari 27.0 |
| iPhone | iPhone 17 / iOS 26.2 / Delta 1.7.3 |
| ゲーム | GBA『シナモンふわふわ大作戦』 |
| USB | M5StickS3版でも使用した同一のUSB-Cケーブル。製品名は未記録 |

## ファームごとの試験範囲

| ファーム | 確認した範囲 | 証跡 |
| --- | --- | --- |
| 初期統合版（5,360バイト） | Mac全12キー、保持、部分解放、6→7→6入力。iPhoneの初期操作・接続試験 | [Mac](evidence/p3-sfc-keyboard-2026-11-10.json) / [iPhone](evidence/p4-iphone-delta-2026-11-10.json) |
| 計測版初版・trace v1（5,608バイト） | 接続時保持の比較、アプリ切り替え、ロック復帰、30分使用 | [比較・実用試験](evidence/p4-iphone-delta-2026-11-10.json) |
| Backspace通常版（5,496バイト） | Mac全12キー、左右保持、部分解放、6→7→6入力 | [通常版再試験](evidence/p4-normal-regression-2026-11-10.json) |
| 現在のTab通常版（5,496バイト） | MacのSELECT/B、DeltaのTab登録・ゲーム操作・同時押し・部分解放・再接続3回。内蔵後の入力・接続・30分使用・握り込み・ケーブル軽操作 | [Tab対応版](evidence/p4-select-tab-2026-11-10.json) / [内蔵後](evidence/enclosure-fit-2026-11-11.json) |

現在のTab通常版は、先行するBackspace通常版からSELECTのキーコード1バイトだけを変更しています。Mac全項目をTab版で繰り返した結果ではありません。30分連続使用は後続の内蔵後確認でも問題なしと報告されています。現在のBINの識別情報は [ビルド資料](build.md#成果物を確認する) に記載しています。

## Macでの入力確認

| 試験 | 結果 | 対象 |
| --- | --- | --- |
| 全12ボタンを単独で押下・解放 | 対応するキーが届き、各回全解放 | Backspace通常版 |
| 左右30秒以上の保持・解放 | 左34.785秒、右32.622秒。保持中断なし | Backspace通常版 |
| 右＋Y＋BからBだけ解放 | 3入力を6.343秒、右＋Yを2.254秒保持し全解放 | Backspace通常版 |
| 6→7→6入力 | Wの除外・復帰を2回確認し全解放 | Backspace通常版 |
| SELECT→Tabを3回 | 押下・解放を確認 | Tab通常版 |
| B→Zを1回 | 押下・解放を確認 | Tab通常版 |

保持時間はブラウザで観測した区間です。接点の実時間や入力遅延の測定値ではありません。試行順の記録は [検証履歴](development/validation-history.md) に保存しています。

## iPhone・Deltaでの確認

| 試験 | 結果 | 範囲 |
| --- | --- | --- |
| GBAの10入力登録・ゲームで使う操作 | 正常 | 初期統合版。ゲームで未使用の操作の内訳は未記録 |
| 左右長押し、右＋Bの部分解放 | 正常 | 初期統合版。保持時間は手順上の指定で、独立した実測なし |
| B短押し各10回 | 単独と右保持中の両方で正常 | 初期統合版 |
| 全解放での再接続10回 | 再割り当て不要、操作・解放正常 | 初期統合版 |
| USB-Cの向き4組、抜去中の右解放 | 操作正常、再接続後に入力残りなし | 初期統合版 |
| 全解放でのアプリ切り替え3回 | 操作・解放正常 | trace v1 |
| 全解放でのロック・解除3回 | 操作・解放正常、警告なし | trace v1 |
| 30分連続使用 | 異常・警告なし | trace v1、Delta前面、ロックなし |
| SELECTのTab登録・ゲーム操作 | 正常 | 現在のTab通常版 |
| 斜め・3入力以上、右＋Bの部分解放 | 正常 | 現在のTab通常版。具体的な最大同時数は未記録 |
| 全解放での再接続3回 | 左・右・B・SELECTの操作・解放正常、再割り当て不要 | 現在のTab通常版 |
| 接続前から右を保持 | 押し直すまで反応しない | 未解決（U04） |
| 右保持でロックしロック中に解放 | 復帰後に右入力が残る。右を押して離すと回復 | 未解決（D09） |

SNESの全12入力は旧版でDeltaのキー配置画面を確認しています。SNES実ゲームと、Tabへ変更した後のSNES全12入力再試験は未実施です。Deltaでの6／7入力やSNESの右＋Y＋B部分解放も未確認です。

## iPadでの確認

iPad Air（M2）／iPadOS 26.5／Delta 2.0.1で動作確認済みです。製作者の確認結果に基づきます。使用ゲーム、ファームの識別情報、個別の試験条件は未記録です。iPhoneで行った全試験や、既知の接続時保持・ロック復帰の問題まで検証した結果とは扱いません。詳細は [確認記録](evidence/ipad-validation-2026-11-11.json) を参照してください。

## 内蔵用の別基板

Tab通常版を搭載した内蔵構成について、以下を確認しています。元のコントローラーケーブルを撤去し、AT-PDCASTCC08を基板へ差した状態で収納しています。

| 確認項目 | 結果 |
| --- | --- |
| 書き込み・全セクタ読み戻し・起動・USB認識 | 正常（収納前のツール記録） |
| 絶縁・固定・配線の挟み込み・ボタンとの干渉 | 問題なし |
| 閉蓋後の全12ボタンの押し心地と戻り | 問題なし |
| 全入力・長押し・同時押し・再接続 | 問題なし |
| 30分連続使用 | 問題なし |
| 握り込み・ケーブルを軽く動かした際の安定性 | 問題なし |

書き込み以外は製作者の観察報告に基づきます。使用端末・ゲーム、長押し時間、同時押しの組み合わせ、再接続回数、独立した入力ログは未記録です。従来基板の測定値は転用していません。

[書き込み記録](evidence/enclosure-board-upload-2026-11-11.json) / [収納・内蔵後確認の報告](evidence/enclosure-fit-2026-11-11.json)

後続の写真提供により、[内部配置と完成外観](hardware.md#内蔵用部材と写真) を確認しています。[写真の記録](evidence/enclosure-photos-2026-11-11.json) は従来の動作確認報告と分けています。写真は配置・外観の確認資料であり、電気的な測定や動作試験を追加したものではありません。

## 追加ケーブルの動作確認

2026-11-11、製作者からセリアのUSB-Cケーブル **EM-69A** でも問題なく動作したとの報告がありました。使用端末・アプリ、使用時間、再接続回数、筐体への収納状態は今回の報告では未記録です。AT-PDCASTCC08で記録した内蔵後の30分使用・握り込み・ケーブル軽操作の結果は、EM-69Aには転用しません。

## 公開ページでの実機確認

2026-11-11、[公開の入力確認画面](https://otitbridge.github.io/snes-controller-uiapduino/) をMac・iPhone・iPadで開き、実物のSFCコントローラーで問題なく使えることを確認しています。実機操作者の報告に基づく結果です。

対象ページは `6b8c547` で公開したSFC配置の12ボタン用画面です。[確認記録](evidence/public-probe-validation-2026-11-11.json) を参照してください。

## ビルド・ホストテスト

通常構成とAddressSanitizer／UndefinedBehaviorSanitizerで、以下を検査しています。

- 12ビット入力全4,096通りのキー変換と、24,576通りの1ボタン解放。
- 16ビット入力全65,536通りのSFC読取モデルと、スケッチからUSB setterまでの経路。
- 実コアの共有状態公開、147,456回の割り込み挿入モデル、GET_REPORT応答・コピー保持。
- MCU向けのコンパイルと、固定版コア・依存ツールの照合。

再実行方法は [ビルド・テスト手順](build.md#pc上のロジックとバックエンドのテスト) を参照してください。ホストモデルの成功をUSB実時間や全端末の互換性保証とは扱いません。

## 詳細記録

[試行順の検証履歴](development/validation-history.md) に、失敗・再試験・途中版の結果を保持しています。[公開JSON](evidence/README.md) では観測方法、BIN識別、ログのSHA-256を記録しています。元ログはリポジトリへ同梱していません。
