otitbridge/snes-controller-uiapduino/docs/development/validation-history.md

> 開発記録：2026-11-10の文書整理前の内容を保存しています。試行時点の状態・作業指示を含みます。現在の利用手順は [資料の案内](../publication.md) を参照してください。

# キー変換と最小HIDの検証結果

2026-11-10（日本時間）、P1のホスト上の純粋ロジックテストでL01～L03がPASS、P2では最小HIDのビルド・ホストテスト、全キー解放版と手動単キー版の書き込み・MacでのUSB認識に成功しました。ジャンパ線による単キーの押下・保持・解放もMacでPASSです。その後、P3のSFCキーボード統合版を経てP4を開始し、iPhone 17／DeltaのGBAゲームでB操作3回、続いて10入力の登録とゲームで使う操作の成功を本人が報告しました。詳細と未確認範囲は末尾のP4節に記録します。

## 現在の到達点

通常版（SELECT→Tab）の確認は今回の合意範囲で完了しています。2026-11-10、ユーザー指示によりP5の筐体内蔵・組立後試験を保留し、P6の公開資料整理を先行しました。U04・D09はユーザー裁定で未解決のまま許容、SNES実ゲーム・iPad等の未確認範囲も維持します。[現在の構成と試験範囲](../../README.md)、[公開資料の範囲](../publication.md) を参照してください。以下は試行順の履歴であり、当時の「次工程」「未実施」を現在の再開指示とは扱いません。

## P1の条件と証拠

- 実施：Codexがローカルのコマンド実行結果を確認。
- 対象：`firmware/snes_controller/snes_hid_report.h` の12ビット入力から8バイトのHIDレポートへの変換。
- ベースコミット：`112a816`。P1の変更は実行時点で未コミットのため、[実行記録](../evidence/p1-host-tests-2026-11-10.json) のソースSHA-256で特定。
- OS／CPU：macOS 26.7.1／Darwin arm64。
- コンパイラ：Apple clang 21.0.0（`c++`）、C++14。`-Wall -Wextra -Werror -pedantic -DNDEBUG` を指定。
- 実行方法：通常の `-O2` と、`-O1`＋AddressSanitizer／UndefinedBehaviorSanitizerの2構成。両方とも終了コード0、警告・sanitizer診断なし。
- バイナリ：`.local/host-tests/hid_report_test` と `hid_report_test_sanitized`。ホスト用実行ファイルであり、MCU用ファームウェアではない。SHA-256は実行記録に保存。
- MCU用のコア／FQBN／USBモード／Flash・RAM使用量：今回のホストテストでは対象外。
- 実物の基板・コントローラー・接続ピン・端末・Delta・ケーブル：今回の試験では使用していない。

再実行コマンド（プロジェクトのルート）：

```sh
bash tests/run_host_tests.sh
SNES_HOST_SANITIZERS=1 bash tests/run_host_tests.sh
```

## 実施したロジック試験

| ID | 条件・手順 | 期待結果 | 実際の結果 |
| --- | --- | --- | --- |
| L01 | 全解放、全12ボタンを各1入力、全ボタン入力を与える。ボタンのビット定義も確認 | 引き継ぎ仕様のUsage ID。modifiers／reservedは0、未使用枠は0 | PASS、通常・sanitizerの両構成 |
| L02 | 下位12ビットの全4096通りを列挙。キーの所属・順序・個数・重複・0埋めを確認 | 押下ボタンのうちbit順の先頭6個だけが出力される | PASS、全4096通り |
| L03 | 7キー→6キーの具体例と、全4096通りの押下状態から1ボタンずつ離す24576通りを確認 | 解放したキーが消え、枠が空けば除外されていた保持キーが現れる | PASS、具体例と全24576通り |

L03の具体例は、右＋B＋Y＋A＋L＋RへSTARTを加えるケースです。7キー時はRが出力枠から外れ、STARTを離すとRが復帰しました。これはレポートのバイト列に対する確認で、DeltaのD05試験は未実施です。

追加で以下を確認しました。

- 全65536通りの `uint16_t` 入力で、上位4ビットを変えても出力が変わらない。
- 単キー・3キー・12キーの入力をそれぞれ3000回与えてもレポートが変わらない。
- 全4096通りで、途中に別の押下状態を挟んでも元の入力に対する結果が変わらない。
- 右＋Y＋BからBだけを離したとき、右とYが残る。全解放で全キー枠が0になる。
- 8バイトのサイズ、各フィールドの位置、コピー可能な構造を確認。
- `Keyboard` というグローバルオブジェクトをテスト側で定義してもコンパイルできる。実際のArduino `Keyboard.h` との統合ビルドはP2で扱う。

3000回の反復は状態の不変性を確認するための呼び出し回数です。実時間の30秒保持、USBでの保持、短押しの最小時間を測ったものではありません。

## P2の条件と証拠

- 実施：CodexがローカルのCLI・コンパイラ・テストの結果を確認。
- ベースコミット：`3b961e0`。P2の変更は実行時点で未コミット。ソース・成果物は [P2の記録](../evidence/p2-build-2026-11-10.json) のSHA-256で特定。
- 環境：macOS 26.7.1／Apple Silicon、Arduino CLI 1.5.1 x86_64、xPack RISC-V GCC 14.2.0-2。
- コア：`UIAP_HID:ch32v@1.2.15`、参照SHA `9471a150c9837c9055ef62ef759a1a593eddf1b1`、パッチなし。配布物全730ファイルを導入内容と照合済み。
- FQBN・USB：V1.4、48MHz HSI、`usb=kbd`、UARTなし、`-Os -flto`。完全なFQBNとコマンドは [build.md](build-history.md) とJSON記録に保存。
- 基板：本人申告のV1.4・5Vを対象にした設定。この節のビルド時点では書き込み・実測は行わず、その後の書き込み結果は次節へ記録。

| ビルド | 条件 | BIN | CLIのFlash表示 | 静的RAM | 状態 |
| --- | --- | ---: | ---: | ---: | --- |
| `neutral` | GPIOを読まず全解放 | 3116バイト | 2956バイト | 156バイト | ビルド成功（書き込み結果は次節） |
| `manual` | PC5のLOWでB→Z | 4084バイト | 3924バイト | 176バイト | ビルド・書き込み・Mac単キー試験に成功（下記） |

CLIのFlash集計には `.init` が含まれず、今回の差は両ビルドとも160バイトです。容量はボード定義上Flash 16,384／RAM 2,048バイトで、リンカはスタック用境界として448バイトを置きます。実際のスタック余裕やブートローダとのメモリ整合は未測定・未確認です。

バックエンドは、開始前の全解放、Zキー保持・解放、部分解放、6キー上限からの復帰、Raw Usage IDと8バイト状態の受け渡しをテストダブルで確認しました。P1テストと合わせ、通常・sanitizerの両構成でPASSです。キーボード用モード未指定とWebHID-onlyとの競合も、コンパイルで拒否されました。

これらのテストはvoid setterへの引数と呼び出し順を対象にしており、USB割り込み・ホスト受信・再接続の証拠ではありません。共有バッファは逐次更新のまま、最小ファームの実機用入力は全解放と単キーだけに限定しています。

## 全キー解放版の書き込みとU01

- 日時：2026-11-10、日本時間。正確な開始・終了時刻は [書き込み記録](../evidence/p2-upload-neutral-2026-11-10.json) に保存。
- 実施：本人が基板を接続・書き込みモードへ再接続し、Codexがデバイス情報・書き込みログ・USB／HID情報を確認。
- ファーム：`neutral`、3116バイト、SHA-256 `27f8d5e11dca454433b8b6eccff781035236165d22fe5e462c79b2b9841233bd`。ソースはP2ビルド記録のSHA-256で特定。
- 書き込み前：`32V003`、VID:PID `1209:B803`、`bcdDevice=0x0141` の対象が1台。本人申告の基板V1.4・5V、実測電圧は未記録。
- 使用ツール：`uiapflash` 1.0.0、macOS用。配布物と実行バイナリの一致も確認。
- 書き込み：`0x08000000`～`0x08000C3F`、3136バイトにパディング。2周目に全セクタ一致、ベリファイOK、アプリ起動、終了コード0。
- 診断：途中に0バイトの受信診断があり、その後に読み戻し一致まで完了。詳細はstderrも含めて記録。
- 書き込み後：同じUSB接続位置に `UIAPduino KBD+Mouse`（`1209:D004`）が列挙。macOSのIORegistryにキーボード（Usage Page 1／Usage 6、入力8バイト）とマウス（Usage 2、入力4バイト）が現れた。
- 判定：書き込み・読み戻し検証はPASS。U01のPCでのUSBキーボード認識もPASS。
- この時点の未確認：実キー入力、USB-Cの反転・再接続反復、スリープ復帰、SFC読み取り、iPhone／Delta、iPad。ケーブルの型番・実測電源・ブートローダ全体のハッシュは未記録。

ブートローダ領域の書き換えは実施していません。手動単キー版の独立した試験結果は次節に記録します。

## 手動単キー版の書き込みとMac試験

- 日時：2026-11-10、日本時間。書き込み開始14:50:01、終了14:50:07。試験画面のセッション開始14:58:08。詳細は [記録](../evidence/p2-manual-hid-2026-11-10.json)。
- 対象：本人申告のV1.4・5V。`32V003`（`1209:B803`、記述子 `0x0141`）が1台であることを照合し、前回と同じ `uiapflash` 1.0.0を使用。
- ファーム：`manual`、4084バイト、SHA-256 `254251c3e42635c5795f7e42b8e94872541dd205eb29f0f32330f4e182a7c00d`。P2ビルド時からMCU用ソースとBINに変更なし。
- 書き込み：4096バイトへパディング、`0x08000000`～`0x08000FFF`。2周目に全セクタ一致、ベリファイOK、アプリ起動、終了コード0。途中の0バイト受信診断25件も保存。ブートローダ領域の書き換えなし。
- 書き込み後：同じUSB接続位置に `UIAPduino KBD+Mouse`（`1209:D004`）が再認識された。
- 接続の訂正：当初は反応せず、本人が基板の「5」とGNDを接続していたと訂正。「7」（PC5／`GPIO_PIN_7`）とGNDへ変更後、同じファームのまま正常動作した。ピンヘッダははんだ付け済みとの本人申告。
- 観察方法：本人がジャンパ線を操作し、CodexがmacOS 26.7.1／Safari 27.0の [入力確認画面](../../tests/keyboard_probe.html) の表示を確認した。PC側のZキーを押さない手順で本人からも3回の正常動作の報告を得た。

| 意図した試行 | ブラウザで観測した保持時間 | 解放 |
| --- | ---: | --- |
| 1回目（目標5秒） | 6.084秒 | 確認 |
| 2回目（目標5秒） | 6.121秒 | 確認 |
| 3回目（目標30秒以上） | 30.908秒 | 確認 |

画面上の総数は押下5回／解放5回で、上記3回に先行する0.060秒・0.007秒の短い2回もありました。その原因は測定しておらず、デバウンスや短押しの合格証拠にはしていません。フォーカス喪失は2件でしたが、保持中にフォーカスを失うと時間を無効にする画面で、5回とも数値の保持時間が表示され、保持中断の表示はありませんでした。

MacでのRaw HID取得は、専有で `0xe00002c1`、非専有で `0xe00002c5` により失敗しました。この試験はブラウザの `KeyboardEvent` を観察したもので、USBレポートのバイト列・転送間隔・入力元デバイスの識別は取得していません。デバイスとの対応づけはジャンパ線だけを操作する本人の手順に依存します。事前のPC本体のZキーによる確認は、この実機合格に含めていません。

判定は、この条件のMac単キー押下・保持・解放がPASSです。ケーブル型番・長さ、実測電源、遅延、短押し保証、再接続・スリープ復帰、SFC入力は未確認です。iPhone 17／Deltaの割り当てと操作は本人の希望で後日実施し、OS・Delta版も未記録です。方向キーや全12入力の試験には一般化しません。

## 検証マトリクスの現在の状態

| ID | 試験 | 状態 |
| --- | --- | --- |
| L01 | 全キー変換 | PASS（ホスト） |
| L02 | 全入力組み合わせ | PASS（ホスト） |
| L03 | 上限からの復帰 | PASS（ホスト） |
| H01 | 通電前確認 | 一部確認（版数・5V設定と配線修正は本人申告。電圧・導通の実測記録はなし） |
| U01 | PCでUSB列挙 | PASS（Mac。手動単キー版も再認識・キー入力を確認） |
| U02 | USB-C直結 | PASS（同じケーブル・向きで再接続10回。毎回、再割り当てせず左・右・Bの操作と解放が正常との本人報告） |
| U03 | USB-Cの向き | PASS（基準の向きはU02、iPhone側だけ・両端・UIAPduino側だけの反転3組も正常との本人報告。同じケーブルの計4組） |
| U04 | 起動時保持 | 未解決・ユーザー裁定で許容（解消を次工程の条件としない。現ファームはMac／iPhone Safariで保持成功、iPhone Deltaでは押し直しが必要。全ボタンを離して接続する運用で実用試験を継続。PASSへ変更しない） |
| D01 | Deltaで全12操作 | SNES全12入力はキーレイアウト設定画面で本人確認済み（設定画面はPASS）。実ゲームはROM未所持のため未確認。GBAの10入力登録とゲームで使う操作はPASS |
| D02 | 方向長押し | PASS（GBAで左右各35秒以上の保持・解放を指示し、正常との本人報告。実時間の計測ログなし） |
| D03 | 複数同時押し | PASS（本人報告: GBA『シナモンふわふわ大作戦』で斜め・3入力以上も確認済み。具体的組み合わせ・最大入力数・回数は未申告。D05へ一般化しない） |
| D04 | 部分解放 | 一部PASS（GBAで右＋BからBだけ解放。SNESの右＋Y＋Bは未実施） |
| D05 | 6キー・7キー | 未実施 |
| D06 | 短押し・連打 | PASS（GBAでB単独10回・右保持中10回、右保持と全解放も正常との本人報告。最小押下時間・速度の実測なし） |
| D07 | 抜去中の状態変更 | PASS（右保持中に抜去→抜去中に解放→全解放で再接続。古い右入力は残らず、操作・解放も正常との本人報告） |
| D08 | アプリ切り替え | PASS（全解放・USB接続維持でDelta→Safari約5秒→Deltaを3回。毎回、再割り当て不要で左・右・Bの操作と解放が正常との本人報告。保持中の切り替えは対象外） |
| D09 | スリープ・復帰 | 条件別: 全解放での3回はPASS。右を保持してロック→ロック中に解放→復帰はFAIL（右入力が残るとの本人報告）。右の押し直し・解放で回復を確認。原因は未確定（Delta側処理が有力候補）。未解決のままユーザー裁定で許容し、次工程を妨げない。給電・USB再列挙は未測定 |
| D10 | 連続使用 | PASS（本人報告: GBAを30分ちょうどプレイ、異常・警告なし。切り替え前の計測版初版、Delta前面・ロックなしの条件） |
| I01 | iPad | 未実施 |
| M01 | 内蔵後 | 未実施 |

Macの単キー試験とP4の統合版試験を経て、現在の基板は通常版 `sfc-keyboard` へ切り替え済みです。切り替え後は書き込み・読み戻し・MacのUSB/HID列挙まで確認し、操作試験は未実施です。以下の実用試験は先行するP3版／計測版初版（trace v1）の結果です。GBAの10入力登録とゲームで使う操作、左右長押し・右＋Bの同時押しと部分解放、B単独と右保持中の短押し各10回、全解放状態でのUSB再接続10回、USB-Cの向き4組、抜去中の右解放は本人報告で成功しました。一方、U04は保持していた右が接続時に反応せず、押し直しが必要だったため未合格です。本人の明示的な選択によりU04は未解決のまま保留し、全ボタンを離して接続する運用で残りの実用試験を進めます。SNESの全12入力とは分けて記録します。

## P3のSFC診断準備と未接続時の確認

本人から、既存M5StickS3版と同じコントローラーを使い、5信号の接続点を特定済みとの報告を得ました。当初は線色との照合が必要として実配線を延期し、その後、本人からSFC基板1＝茶/GND、2＝赤/DATA、3＝橙/LATCH、4＝黄/CLOCK、5＝白/VCCとの対応が提示されました。[配線表](wiring-history.md) に本人申告として反映しました。この節は配線前の確認で、その後に実施した実配線試験は次節へ記録します。

- 読み取り：最初のビットをCLOCKで進める前に読み、全16ビットのDATA電位を保持。LOWを押下へ反転し、下位12ビットを取り出す。割り込み禁止区間は追加しない。
- ホストテスト：全65,536通りの16ビット入力を、CLOCK立ち上がりでだけ進むシフトレジスタモデルで確認。サンプル順、12µs／6µsの要求値、16回のCLOCK、上位4ビットの保持・マスク、7/8/9のピン設定を確認した。通常とASan／UBSanの両方でPASS。
- 診断API：busy中は共有バッファを上書きせず、次のループで新しい状態を試す。8バイトの固定形式、全解放でのUSB開始、8ビットsequenceの折り返しをホストテストで確認。設定の競合と誤ったUSBモードの4ケースはコンパイルで拒否された。
- ビルド：コア1.2.15は未変更。V1.4／48MHz HSI／`usb=kbdweb`。BIN 5536バイト（`.init` 160＋`.text` 5376）、静的RAM 256バイト。完全なFQBNとSHA-256は [P3記録](../evidence/p3-sfc-diagnostic-2026-11-10.json) に保存。
- 互換性：同じソースでビルドした `neutral` と `manual` のBINは、P2で実機確認したSHA-256と一致。元のP2成果物も手元に保持。
- 書き込み：対象1台を照合し、5568バイトの読み戻し一致とアプリ起動を確認。ブートローダの書き換えなし。SFCと単キー試験用ジャンパ線は未接続。
- USB受信：Macでマウス、キーボード、vendor HID（Usage Page `FF00`／Usage `1`、入力8バイト）を確認。Mac用取得コマンドを15秒指定で実行し、1476フレームを受信。不正0件、全フレーム `raw=0xFFFF`／`pressed=0`、連続sequenceの差はすべて1。

初回の単独vendor HID（`usb=webhid`）では書き込み検証に成功した一方、MacにUSBインターフェースが現れず、取得ツールは対象0台で終了しました。その設定の構成記述子は宣言41／実データ34バイトでした。宣言・実データとも84バイトの同梱複合設定へ変更後に受信できました。この差だけを唯一の原因と断定せず、初回の失敗・設定変更・最終結果を記録しています。

未接続での全HIGHはINPUT_PULLUPと整合しますが、SFCが接続されていることや全解放の確認には使えません。この診断版のキーボード側は全解放のままです。CLOCK／LATCH波形は未測定です。続くキーボード出力の統合と共有バッファ対策は後の節に記録し、iPhone／Deltaは本人の希望により後日実施します。

## P3の実配線後の入力診断

2026-11-10、本人が実配線してMacへ再接続し、筐体を組んだSFCの通常ボタンを操作しました。CodexはmacOS 26.7.1のvendor HID取得ツールで入力を記録しました。ファームはコミット `dd5d935` の `sfc-diagnostic` で、BINのSHA-256は前節と同じ `6d777773dab78f47c1ca1d42d1ddb67605a95e3be64af1bfdc72c2755ff9faeb`。ソース・手元のBINと前回の書き込み記録を照合し、この試験での再書き込み・Flash読み戻しは行っていません。

初回は全12ボタンとBの約10秒保持に応答せず、14,378フレームすべて `raw=0xFFFF`／`pressed=0` でした。USBを外して接続表を確認するよう依頼した後、本人から配線の相違を修正して再接続したとの報告を得ました。修正した具体的な接続箇所は未記録です。同じファームのまま、修正後の結果は次のとおりです。

| 診断操作 | 観測結果 | 判定 |
| --- | --- | --- |
| 全12ボタンをB、Y、SELECT、START、上、下、左、右、A、X、L、Rの順で単独操作 | bit 0～11が1個ずつ立ち、各回0へ復帰。観測した押下区間は0.184～0.544秒 | PASS |
| 左を30秒以上保持して解放 | 左だけが39.056秒続き、0へ復帰 | PASS |
| 右だけを30秒以上保持して解放（再試験） | 右だけが41.289秒続き、0へ復帰。他ビットの混入なし | PASS |
| 右＋Y＋Bを保持 | 3ビットが6.663秒続いた | PASS |
| Bだけ解放し、右＋Yを保持した後に全解放 | Bが消え、右＋Yが4.664秒続き、その後0へ復帰 | PASS |

最初の右保持では右ビットは31.400秒続いたものの、下ビットも複数回現れました。本人から「下側にも触れていた可能性がある」と回答を得て、右だけの再試験を実施しました。再試験の合格と、最初の混入原因が未測定であることを区別して記録しています。

修正後の一連の取得は19,026フレーム、右単独の再取得は7,232フレームで、不正フレーム0件、各取得内の連続sequenceはすべて1ずつ進みました。各時間は最初の押下サンプルから次の状態を受信するまでのMac側の観測値で、物理接点の保持時間や遅延の測定ではありません。サンプル間の短い変化の保持も保証しません。

詳細な時刻・ソースとBINの識別情報・各ボタンの観測区間・生ログのハッシュは [実配線の記録](../evidence/p3-connected-sfc-2026-11-10.json) に保存しました。これは**SFC入力をvendor HIDで診断した結果**です。この試験時点ではキーボード側は全解放で、SFCからのキーボード出力と6キー上限からの復帰は後の統合版で別に試験します。再接続・スリープ、DeltaのD01～D10、写真、導通・電圧、CLOCK／LATCH波形は未試験・未測定・未保存です。

## P3のSFCキーボード統合とMac試験

2026-11-10、コミット `b2db0af` の入力診断後に、SFCキーボード統合版を実装・ビルド・書き込みました。
ソース・パッチ・成果物のSHA-256、実行ログと試験区間は [統合版記録](../evidence/p3-sfc-keyboard-2026-11-10.json) に保存しています。

### 実装とホスト上の検査

- `sfc-keyboard` の実際のスケッチへ全4,096通りのSFC入力を与え、USB setterまでのキー状態、保持・部分解放・6キー上限からの復帰を確認。
- 元のコア1.2.15は保持し、専用コピーの `uiapusb.c/.h` だけへ [管理パッチ](../../patches/README.md) を適用。2つの8バイト配列と1バイト索引で完成状態を公開し、割り込み禁止は追加しない。
- 実際の原コアと変更後のsetter／USB読取から作ったホスト試験で、原コアの新旧混在を再現。変更後は147,456回の割り込み挿入で完全な旧状態または新状態だけを確認。通常とASan／UBSanの両方でPASS。
- 全70個のcore／variantコンパイラ入力が専用コピーを参照すること、RISC-V生成コードで8バイトstore後に1バイトの索引を公開し、USB側は索引を1回loadすることを確認。
- 不正なモードや未変更コア等の5ケースをコンパイルで拒否。従来の3モードは実機確認済みBINとハッシュ一致。

FQBNはV1.4／48MHz HSI／`usb=kbd`、UARTなし、`-Os -flto`です。BINは5,360バイト（`.init` 160＋`.text` 5,200）、静的RAMは188バイト。
BINのSHA-256は `edc6c6cbf3e1992ebaa192af435bf7854040cff6a14db8f0762e6f15a924d674` です。

### 書き込み

`32V003`／`1209:B803`／記述子 `0x0141` の対象1台と、BIN・`uiapflash` のハッシュを照合しました。
初回は16:06:34～16:06:36（日本時間）に `0x08000540` の書き込みでFeature Report受信エラーとなり、完了・アプリ起動は確認していません。
**その後、本人から「書き込み途中にUSBを抜き差ししたため」との申告がありました。** 通信失敗はCodexがログで観測した事実、USBの抜き差しは本人申告として記録します。

同一対象とBINを再照合した再試行は16:07:11～16:07:17に終了コード0となり、5,376バイトの全セクタ読み戻し一致、ベリファイOK、アプリ起動を確認しました。
アプリ範囲は `0x08000000`～`0x080014FF`（パディング込み）で、ブートローダ領域は書き換えていません。
再列挙後はMacでKeyboard+Mouseを認識し、キーボードはUsage Page 1／Usage 6・入力8バイトでした。
この書き込み時点の基板は `sfc-keyboard` でした。現在のU04調査用の一時切り替えは後述します。

### Macでの操作

本人がSafariの [SFCキーボード試験画面](../../tests/sfc_keyboard_probe.html) を前面に保ち、SFCだけを操作しました。
macOS 26.7.1／Safari 27.0のキーイベントを、Mac内のループバックサーバーで保存しました。合格に使った操作区間にはフォーカス喪失がなく、キーイベントはすべて `isTrusted=true` でした。

| 試験 | 観測結果 | 判定 |
| --- | --- | --- |
| 全12ボタンの単独操作 | Z、A、Backspace、Enter、上、下、左、右、X、S、Q、Wの順に押下・解放。各回全解放へ復帰 | PASS |
| 左右の長押し | 左43.089秒、右36.649秒。各方向だけを保持して解放 | PASS |
| 右＋Y＋B → Bだけ解放 | 3キーの状態が7.576秒、B解放後の右＋Yが6.188秒続き、その後全解放 | PASS |
| 6→7→6入力 | B＋Y＋SELECT＋START＋L＋Rを保持して上を追加・解放。R→Wが外れ、上の解放でWが復帰する動作を5回記録 | PASS（再試験） |

最初の上限試験2回は、STARTを追加する前にRまたは上が解放されており、所定の6→7→6入力の判定には使っていません。
入力を保持しやすい上表の組み合わせへ変更した試験では、残る5キーが保たれたまま、上とR→Wの選択が5回切り替わり、48.170秒のイベントで全解放へ戻りました。
本人からもRが消えて戻ったとの報告を得ました。最初の崩れについて、手操作とデバイス動作を独立に測定したものではありません。

試験の前後には短い右入力や任意の追加操作も記録されました。合格に使うセッション・時間区間をJSONに明示し、これらを30秒保持や上限復帰の証拠へ含めていません。
生ログは `.local/logs/` に保持し、公開記録にはそのハッシュと対象区間のイベントを保存しました。試験後は記録サーバーを停止しています。

これはブラウザが受け取ったキーイベントで、Raw HIDのバイト列、接点からの遅延、入力元デバイスの識別を測定したものではありません。
入力元はSFCだけを操作する本人の手順と対応づけます。setterの転送完了通知、短押し保持、起動時保持、再接続・スリープ復帰の保証は追加していません。
このMac試験時点ではDeltaのD01～D10とiPadは未試験でした。続くiPhone／Deltaの初期結果は次節に記録します。

## P4のiPhone／Delta初期試験（GBA）

以下は試行順の履歴です。現在の合否は上の検証一覧、基板の版は [P4証跡](../evidence/p4-iphone-delta-2026-11-10.json) の `current_device_firmware` を参照してください。

2026-11-10、本人がiPhone 17へ通常接続して試験しました。初期試験ではP3の `sfc-keyboard` 統合版を使用し、その時点の再書き込みは行っていません。ファームの識別は [P3の統合版記録](../evidence/p3-sfc-keyboard-2026-11-10.json)、今回の条件・本人報告は [P4の記録](../evidence/p4-iphone-delta-2026-11-10.json) を参照してください。

- 環境（本人申告）：iOS 26.2、Delta 1.7.3、GBA『シナモンふわふわ大作戦』。
- ケーブル：M5StickS3版で使ったものと同じとの本人申告。型番・長さは未記録。
- 指示した操作：Deltaでキーボードを選択してBを割り当て、実物のBを約1秒押して約2秒離す操作を3回行う。
- 本人報告：「GBA ROMですが、 3回とも正常に操作できました」。この条件のGBAのB操作はPASSとします。
- 観察方法：本人のゲーム内動作の報告。CodexはiPhone画面・キーイベント・Raw HIDを観測しておらず、割り当て画面のZ表示、実際の押下時間や解放時刻は独立に確認していません。

本人はGBAでの継続を希望しています。続いて上下左右・A・B・L・R・SELECT・STARTの10入力を表の対応で登録し、保存後にゲームで使う操作を1個ずつ試すよう案内しました。本人から「10入力を登録でき、ゲームで使う操作も正常」との報告を得たため、この条件の10入力登録とゲームで使う操作はPASSです。ゲーム内の未使用項目の名前は申告されておらず、10入力すべてのゲーム内効果を個別に確認したという意味ではありません。

続いて次の3試験を案内し、本人から「3試験とも確認でき、正常だった」との報告を得ました。壁・画面端・場面切り替え等で確認できない項目は申告するよう依頼しましたが、今回その申告はありません。

| GBAで指示した試験 | 本人報告による結果 |
| --- | --- |
| 左だけ35秒以上保持→解放→約2秒待つ | 正常、PASS |
| 右だけ35秒以上保持→解放→約2秒待つ | 正常、PASS |
| 右＋Bを約5秒→Bだけ離して右を約5秒→全解放 | 右を保持しながらB操作ができ、B解放後も右入力が続く動作は正常、PASS |

保持時間は指示の目標値で、Codexによる実測値ではありません。今回は右＋Bの2入力での同時押し・部分解放までの確認で、斜めや3入力以上、SNESの右＋Y＋Bへ一般化しません。

続いてB単独と右保持中のBについて、それぞれ短い押下・完全な解放を10回ずつ、目安1秒に1回の速さで試すよう案内しました。本人から「両方とも10回反応し、右の保持・全解放も正常」との報告を得たため、この条件のD06はPASSです。押下時間・繰り返し速度やHIDレポートは実測しておらず、最小押下時間や任意の速度での欠落防止を保証する結果ではありません。

続いて全ボタンを離した状態で、iPhone側のUSBを約3秒外して同じ向きで再接続し、約3秒後に左・右・Bの操作と解放を確認する手順を10回案内しました。本人から「10回すべて、再割り当てせず正常に操作・解放できた」との報告を得たため、この条件のU02はPASSです。接続中に保持した入力を抜去中に変える試験や、別ケーブル・向きの組み合わせへは一般化しません。

U02で成功した向きを基準に、iPhone側だけ反転、両端とも反転、UIAPduino側だけ反転の3組み合わせで、再割り当てせず左・右・Bの操作と解放を確認するよう案内しました。反転は同じプラグを180度回して挿すことで、ケーブルの両端の接続先は維持します。本人から「3組み合わせとも正常に操作・解放できた」との報告を得たため、両端とも基準の向きであるU02の結果と合わせて、同じケーブルの4組をU03のPASSとします。プラグの写真、CCや電源の測定、USB列挙ログは取得していません。

①右を押したまま通常接続し、約5秒保持してから離すU04では、本人から「接続時は反応せず、離して押し直すと反応した」との報告を得ました。押し直さず現在状態へ同期する合格条件を満たしていないため、U04はFAILとして課題を残します。USB HIDの仕様、ファームウェア、iOS／Delta、ゲームのいずれが原因かは、この報告だけでは断定しません。

②右を保持中にUSBを抜き、抜去中に右を離してから全解放状態で再接続するD07では、「再接続後に右入力は残らず、操作・解放も正常」との報告を得たため、この解放条件はPASSです。別の入力を押した状態での再接続は未確認です。

ソースでは約10msごとに現在状態をsetterへ渡し、USBのIN要求には最新の完成したレポートを送る構造です。ただしUSB開始前に設定した全解放がホストへ届いたことや、Deltaが入力を受け取れる状態になったことを通知するAPIはありません。これはソースの確認結果で、今回のUSB実通信や原因を証明するものではありません。この初期試験時点ではファームの変更・再書き込みは行っていませんでした。

U04の保持時間を15秒へ延ばし、右を離さずにBを1回操作して、最後に右を離して押し直すよう案内しました。本人から「15秒後も右は反応せず、Bは反応した。右は押し直すと反応した」との報告を得ました。待機時間の延長やB操作では解消せず、追加のB入力はゲームへ反映されることを確認しました。SFC入力・ファームウェア・USB／OS・Delta・ゲームの原因はまだ特定していません。

同じiPhoneのSafariで [W3CのKeyboard Event Viewer](https://w3c.github.io/uievents/tools/key-event-viewer.html) を使った比較では、通常押下でも、右を保持したままの接続でも `keydown` が出たとの本人報告を得ました。ただし接続時は短時間で `keyup` が出たとのことです。当初「6キー分」と表現された回数は、添付画像により「7キー分」へ訂正されました。画像の可視範囲は次の通りです。

| 画像の行番号 | イベント | key／code | repeat表示 |
| --- | --- | --- | --- |
| 56 | keydown | ArrowRight | false |
| 57～62 | keydown（6件） | すべてArrowRight | true |
| 63 | keyup | ArrowRight | false |

これは同じ右1キーの初回keydownとリピート6件、その後のkeyupで、7種類の同時押しやUSBパケット数を表すものではありません。本人は「Safariで接続時のkeydownの後にkeyupが出た際、実物の右は押し続けていました」と明確に回答しました。接続時のkeydown自体は届いていますが、物理保持中にブラウザ側へ解放イベントが出る症状です。画像に時刻はなく、持続時間・フォーカスの連続性・Raw HIDは測定していません。Deltaだけの問題とは断定できず、SFC入力・ファームウェア／USB・OSやフォーカスを切り分けます。

MacのSafari 27.0に既存の [SFC入力確認画面](../../tests/sfc_keyboard_probe.html) を開き、通常接続後の右15秒保持と、右を保持したまま接続して15秒保持する場合を比較しました。途中で全解放の表示になっても、実物の右は15秒まで押し続けるよう案内しました。本人は「通常接続後の長押しは正常　押したまま接続しても、全開放のままだった」と報告しました。

ループバック専用のサーバーで保存したログでは、通常保持のセッション `2026-11-10T08:18:41.777Z` に右のkeydownと14.686秒後のkeyupがあり、保持中のフォーカス喪失はありません。接続時保持のセッション `2026-11-10T08:19:04.290Z` にはkeydown／keyupがなく、開始30.379秒後まではフォーカス喪失の記録もありませんでした。開始時の別セッションにある短い0.207秒の右入力は対照試験へ含めません。これはブラウザの観測で、SFCの生データやUSBレポートではありません。

生ログ `.local/logs/p4-u04-mac-comparison-2026-11-10-02.jsonl` は13件、SHA-256は `50e2f003f394576a5db17a2fa8325e1618b1f804e3b46fc54e5ea255e87a698c` です。記録サーバーを正常終了させて保存しました。ファームはこの比較のためには変更していません。

実機確認済みの `sfc-diagnostic` BIN（5,536バイト、SHA-256 `6d777773dab78f47c1ca1d42d1ddb67605a95e3be64af1bfdc72c2755ff9faeb`）へ一時的に切り替えました。2026-11-10の17:27:34～17:27:41（日本時間）、`32V003`／`1209:B803`／記述子 `0x0141` の1台へ書き込み、5,568バイトの全セクタ読み戻し一致・アプリ起動・終了コード0を確認しました。アプリ範囲は `0x08000000`～`0x080015BF`、ブートローダの書き込みは行っていません。再列挙後は同じUSB接続位置にKeyboard+Mouse+Webを確認しました。

この入力診断版はキーボード全解放のみ、vendor HIDへSFC生データを出します。最初の240秒の取得は右押下もUSB抜去の間隔も含まず、本人の操作時刻と対応できなかったため判定には使いません。取得を600秒へ延ばし、通常押下を確認してから再接続を案内しました。

2回目のログには27,656サンプル、不正0件があり、通常の右保持は4.976059秒でした。再接続の7.614483秒の受信空白後、最初のフレームから右が継続し、11.015835秒後に解放、続いて0.879897秒の押し直しと解放を記録しました。本人は接続時の右を20秒保持したと報告しています。USB認識待ちを含む物理保持時間全体は独立計測していないため、観測値11.02秒を20秒保持の不成功と判定しません。診断版のUSB構成・通信量は統合版と異なり、統合版のキーボード出力を証明する結果ではありません。ログは正常終了し、SHA-256は `00c34fcc85eb3cc284e1f256f831ad01ff050d657937c6c2ff142562a923b9d8` です。

純粋なKeyboard+Mouse設定ではGET_REPORT(Input)のルーティングが無効なことを別途確認し、応答候補を管理パッチとして追加しました。実際のコア設定・ルーティング・状態配列・setter・応答処理を使った回帰テストで元の空応答と候補の内容・長さ・EP0コピー保持を確認し、既存テストを含む通常・ASan／UBSan構成に合格しました。GET_REPORTの役割は [USB HID 1.11 §7.2／§7.2.1](https://www.usb.org/sites/default/files/hid1_11.pdf) に基づきますが、今回ホストが送った要求のトレースはなく、U04の原因とは確定していません。

候補はBIN 5,496バイト／静的RAM 196バイト、SHA-256 `e08cd59d66d77f36901c2e8a255cca5f2c89e8ddabcc4dc6fa95ab96c1d4937e` です。17:48に同じ1台へ書き込み、5,504バイトの全セクタ読み戻し一致とアプリ起動を確認しました。この時点では基板にこの候補を書き込みました。現在の書き込み済み版はP4記録の `current_device_firmware` を参照してください。従来の5,360バイトの統合版BINも `.local/build/sfc-keyboard-before-get-report/` に保存しています。

Macでの候補再試験は通常押下4.286秒が正常でしたが、右保持での接続はkeydownから1.012秒でkeyupとなりました。本人はその時点でも右を保持していたと報告し、ログの最初のフォーカス喪失も35.653秒と後です。GET_REPORT対応だけではU04は解消しません。その後、基板のキーボード状態をEP0から直接読み、入力状態とホストイベントを分けて調べました。これは受動的なInterrupt INの記録とは別です。

EP0からの取得では、483件すべてが8バイトの応答に成功しました。抜去と再認識中は56回取得できず、その後最初の成功から11.973739秒間、右のキーコード `0x4F` が継続し、解放と押し直しも取得しました。本人は接続時の右を20秒保持したと報告しています。基板の現在のキーボード状態が早期に消える現象はこの試験では観測していませんが、Interrupt INへの送信・ACK・OS処理はまだ分かれていません。

このため、先頭キー枠とキーボードIN要求・ACKの回数を読む一時計測版 `sfc-keyboard-trace` を用意しました。ホストの通常・ASan／UBSanテストに合格し、BIN 5,608バイト／静的RAM 204バイトでビルドしました。計測を無効にした通常候補は、追加前と同じBINハッシュになることを確認しています。

この時点ではSNESの全12入力、未実施の同時押し条件、U04の原因と対処、アプリ切り替え・ロック復帰・30分連続使用は未完了でした。後続のD08〜D10結果は下記に記録します。

2026-11-10の再試験では、Karabiner-Elements終了後に非排他的HID取得が成功しました。ファームウェア変更なしの計測版初版で、右を保持したまま再接続すると、最初のHID入力から解放まで12.228298秒、Safariでは12.186秒の保持を確認し、途中の解放はありませんでした。全取得レポートの記録とブラウザのリピート記録を同時に取得しています。要求した20秒を実測した結果ではなく、観測できた区間の保持・解放成功です。Karabiner再有効化による対照試験は未実施で、iPhone側のU04も未解決です。その後のiPhone／Delta比較は下記のとおりです。Macの取得プロセスは正常停止し、ログハッシュをP4記録へ保存しました。

同じ現ファーム（GET_REPORT対応を含む計測版初版）をiPhoneへ移した比較では、DeltaのGBAで通常接続後の右保持・解放とBは正常でしたが、右を押したまま接続すると押し直すまで反応しなかったとの本人報告です。iPhone側のU04は引き続きFAILで、Macの成功やKarabiner終了によって解消したとは判定しません。続いて同じ現ファームでiPhone Safariも比較しました。

iPhone SafariのKeyboard Event Viewerを同じ現ファームで比較したところ、通常押下ではkeydownと物理解放時のkeyupが正常で、右を押したままの接続でもkeydownが出て、keyupは物理解放時だけだったとの本人報告を得ました。接続後20秒保持を依頼した試験ですが、時刻ログ・USBトレースは取得していません。現ファームではiPhone Safariの保持は成功し、Deltaだけに接続時の押し直しが残るという比較結果です。Deltaの接続・入力初期化経路を調べる段階で、特定のアプリ／OS不具合の断定や追加のファーム変更はしていません。

D08: 計測版初版のまま、全ボタンを離してUSB接続を維持し、Delta→Safari約5秒→Deltaを3回実施しました。本人から3回とも再割り当て不要で左・右・Bの操作と解放が正常との報告があり、この条件をPASSとしました。保持中のアプリ切り替えとロック・解除は別条件です。

D09の全解放条件は、USB接続を維持してロック約10秒→解除を3回実施し、本人から操作・解放正常、再割り当て不要、警告なしとの報告を得ました。この条件はPASSです。給電が継続したか、内部でUSB再列挙したかは未測定で、保持あり条件の結果は次段落に記録します。

D09追加結果: 右を保持してロックし、ロック中に右を離して復帰すると、右入力が残ったとの本人報告です。その後のボタン操作中は右入力が無効になり、そのボタンを離すと右入力が再び有効になるとのことです。具体的な後続ボタンと順序、HIDレポートは未記録です。この条件はFAILで、U04とは別の未解決事項です。本人は「Delta側の不具合と確認できるなら許容できる」と表明しましたが、原因はまだ確定していません。回復確認は次段落に記録します。

D09回復確認: Deltaを前面にし、USBをつないだまま右だけを約1秒押して完全に離すと、右入力が止まり、その後も戻らないとの本人報告を得ました。この事象の回復手順として記録します。USB抜き差しやRESETは行っていません。回復したことだけでは、解除通知が失われた場所をDeltaと断定できません。

D09ソース確認: Deltaの公開 `v1.7.3` ブランチが参照するDeltaCore `373bf07b7da6630dec661e876a63d685d61b9f9c` では、[解放処理](https://github.com/rileytestut/DeltaCore/blob/373bf07b7da6630dec661e876a63d685d61b9f9c/DeltaCore/Emulator%20Core/EmulatorCore.swift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)が、ゲーム画面にキーボードフォーカスがない場合、エミュレータへ解放を渡さず戻ります。一方、[コントローラー側の状態管理](https://github.com/rileytestut/DeltaCore/blob/373bf07b7da6630dec661e876a63d685d61b9f9c/DeltaCore/Model/GameControllerStateManager.swift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)では通知前に押下状態を消します。この条件で解放が届くと両者の状態が食い違い、前面へ戻って右を押し直して離すことで解消する経路があり、今回の報告と整合します。ただしロック中の実際のフォーカス値・コールバック・HIDレポートは未取得で、Delta原因の確定ではありません。D09はFAIL／未解決のまま、Delta側の処理を有力候補と記録します。ロック・アプリ切り替え前に全解放し、残留時はDelta前面で該当する右を押して離す運用とします（回復は今回1件で確認）。この調査後にファームウェアは変更しておらず、D10の結果は次段落に記録します。

D10（連続使用）は、iPhone 17／iOS 26.2／Delta 1.7.3のGBA『シナモンふわふわ大作戦』で、実プレイ時間30分ちょうど、異常・警告なしとの本人報告を得てPASSとしました。Deltaを前面に保ち、ロックせず、USB接続を維持する条件の試験です。終了時の左・右・B確認も手順に含めましたが、回答には各操作の個別記述はありません。時間と動作は本人報告で、独立した計測ログはありません。この試験時の基板は計測版初版（trace v1）であり、通常版への一般化やU04・D09の解消判定には使いません。

## 追加確認とユーザー裁定

本人から、GBA『シナモンふわふわ大作戦』で斜め・3入力以上を確認済みとの報告を得て、D03のこの範囲をPASSとしました。具体的な組み合わせ・最大数・保持時間・反復回数は未申告です。6／7キー（D05）や追加の部分解放条件（D04）へは一般化しません。

SNES全12入力はDeltaのキーレイアウト設定画面で本人確認済みです。D01は「設定画面確認済み／実ゲーム未確認」と分けます。ROM未所持のため実ゲームは後日とし、全12入力が未認識という扱いにはしません。

U04とD09は、本人が未解決のままでよいと明示的に裁定しました。以前の「Delta側の不具合なら許容」という条件は、今回の進行判断では要求しません。原因未確定と失敗条件を残し、PASS・修正済みへ変更せず、追加原因調査を次工程の前提から外します。接続・ロック・アプリ切り替え前は全解放、残留時はDelta前面で右を押して離す運用を継続します。

## 通常版への切り替え

2026-11-10 21:58、通常版（5,496バイト）へ書き込み、5,504バイトの全セクタ読み戻し一致、アプリ起動、Macで同じUSB位置への再列挙とKeyboard 8バイト／Mouse 4バイトのHIDを確認しました。詳細は [通常版書き込み記録](../evidence/p4-final-normal-upload-2026-11-10.json) を参照してください。監視プロセスは終了済みです。通常版に切り替えた後の全12キー・保持・部分解放・6→7→6入力・iPhone操作は次工程で確認します。U04・D09のユーザー裁定は維持します。

通常版の切り替え後試験を開始しました。MacのSafariでB→Y→SELECT→START→上→下→左→右→A→X→L→Rの12入力が、対応するキーの単独押下・解放として順に届き、各回全解放へ戻ることを確認しました。観測した保持は0.390〜0.913秒、採点区間のフォーカス喪失はありません。全12キー単独操作はPASSで、長押し・部分解放・6→7→6入力とiPhone確認は継続中です。[通常版の再試験記録](../evidence/p4-normal-regression-2026-11-10.json) に区間と証拠を保存しています。

通常版の長押し・部分解放では、右32.622秒の保持・解放がPASS、右＋Y＋Bを6.343秒保持してBだけ離した後に右＋Yが2.254秒残り、最後に全解放となる部分解放もPASSでした。採点区間のフォーカス喪失や余分な方向入力はありません。左は23.125秒の正常な保持・解放を記録しましたが、30秒以上の基準には届かず、左のみ再試験します。物理保持中の意図しない解放が起きたと判定する記録ではありません。

通常版のMac再試験は、左34.785秒の保持・解放で30秒以上の基準を満たしました。6→7→6入力は79.766〜86.307秒の区間でR→Wの除外・復帰を2回確認し、最後は全解放でした。先行する6入力未成立の試行と、他キー解放で終わった後続の上追加は合格回数に含めません。Macの全12キー・左右保持・部分解放・6→7→6入力はPASSとなり、記録サーバーを正常終了してログ全体のSHA-256を保存しました。通常版でのiPhone操作・再接続は次に確認します。

通常版のiPhone確認では、SELECTがDeltaの割り当て画面でも認識されないとの追加報告を得ました。以前からの可能性があり、今回の変更による退行とは未確定です。MacのSELECT→Backspaceは確認済みですが、iPhone側は切り分け中です。他の依頼したゲーム操作の合否はこの回答だけでは確定しません。過去の全入力登録報告と現在のSELECT不応答を分けて記録します。

SELECT切り分けの追加結果: iPhone SafariではSELECTのBackspaceとBのKeyZのkeydown／keyupが両方出たと本人が確認しました。DeltaのBackspace変換経路が有力候補です。SELECTだけをTab（`0x2B`）へ変更した通常版候補を準備し、既存ホスト試験の通常・ASan／UBSan構成とMCUビルドに合格しました。BINは旧通常版と同じ5,496バイトで、差はオフセット4,750の1バイト（`0x2A`→`0x2B`）だけです。候補は未書き込みで、Deltaの受理は未確認です。旧BIN・実機結果は保持し、候補の実機確認後にSELECTだけ再割り当てします。[候補の証跡](../evidence/p4-select-tab-2026-11-10.json) を参照してください。

22:19、SELECT→Tab対応版（BIN SHA-256 `43a82eb36c7df4d298dd01f6b25460117fab0207c9206382b5eeaf92379a9079`）を書き込み、5,504バイトの全セクタ読み戻し一致・起動・同じUSB位置へのMac再列挙を確認しました。現在搭載中なのはこの版で、先行するBackspace版の試験は履歴です。MacのTab押下・解放とDeltaの受理はこれから確認します。

Tab対応版のMac試験は、SELECT→Tabを3回（0.839／1.143／1.187秒）、対照のB→Zを1回（0.680秒）確認し、全て解放後に全解放へ戻りました。採点区間のフォーカス喪失はなく、Tabで入力枠からフォーカスが移ることもありませんでした。最初の試行セッションの任意のTab操作は採点に含めません。記録サーバーを正常終了し、全体ハッシュをSELECT対処記録へ保存しました。次はDeltaのGBA設定でSELECTだけTabへ再割り当てします。

SELECT対処のDelta確認: 本人から「認識されました　タブキーでした　シナモンでの動作も問題ないです」と報告を得ました。現在のTab対応版でGBAのSELECT割り当てと報告されたゲーム動作はPASSです。Backspace不受理の実行時原因を断定せず、Tabへの変更で回避できたと記録します。別システムの設定ではSELECTをTabへ設定する必要があります。通常版の仕上げとして同時押し・部分解放・再接続の確認を続けます。

通常版の仕上げ確認完了: SELECT→Tab版で、斜め・3入力以上の同時押しと、右＋BからBだけを離して右を維持し全解放する操作について、本人から「2点とも問題無しです」と報告を得ました。続いて全解放でのiPhone再接続、左・右・B・SELECTの操作・解放を再割り当てなしで確認する手順に対し、「再接続 3回も問題無しです」と報告があり、3回PASSとしました。実時間・個別イベントの独立計測はありません。これで工程2の通常版確認は今回の合意範囲で完了です。Mac全項目は先行Backspace版、Tab版はSELECT/Bの対象試験と今回のiPhone試験であり、30分試験の再実施ではありません。U04・D09は未解決のまま許容、Deltaの6／7入力・SNES実ゲーム・iPadは別の未確認範囲として残し、次はP5の筐体内蔵と組立後試験です。

SELECT補足: 本人によると、Deltaのキー配置画面ではSELECTにBackspaceが表示されていました。割り当て表示と実際の押下の受理を区別し、今回の不応答記録は維持します。公式履歴ではMac向けの新入力方式を2024年7月に導入し、iOS 26にも2025年9月に適用しています。新方式のBackspace対応漏れが表面化した可能性を有力仮説としますが、実行時原因や直近更新による退行は未確定です。[公式履歴と判断の限界](known-issues-history.md#selectのdelta割り当て不応答tabへ変更して回避済み) と [追加証跡](../evidence/p4-select-tab-2026-11-10.json) を参照してください。確認済みのTab設定を維持し、工程2完了の判定は変更しません。
