otitbridge/snes-controller-uiapduino/tests/sfc_keyboard_probe.html

# UIAPduino SFCキーボード試験

全ボタンを離してコントローラーをUSB接続し、「記録を消して開始」を押してください。 この画面を前面に保ち、SFCの各ボタンを押して離します。SELECTはTab・Backspaceの両方に対応し、受信したキー名を詳細表示とログで確認できます。

Backspaceモードを使う場合は、対応ファームウェアでSELECTを押したままUSB接続し、認識後に離してから試験を開始してください。公開済みv1.0.0はTabのみです。

パソコン側のキーも反応するため、試験中はSFCだけを操作してください。 観測対象はブラウザのキーイベントで、USB機器の接続や入力元を識別するものではありません。

記録を消して開始 ログをダウンロード

全解放

開始ボタンを押してください

押下中は緑の太枠で表示します。図は入力表示用です。

キー名・保持時間を表示

試験記録（Raw HIDレポートではありません）

表示は直近100件、ダウンロードは今回の記録全件（JSONL形式）です。 記録を消す・ページを閉じる前に保存してください。フォーカスが外れたら、全ボタンを離して試験を再開します。 キーボードで枠を離れる場合はEscを押してください。

キー割り当て・使い方 (https://github.com/otitbridge/snes-controller-uiapduino#キー割り当て)

## 30秒ターゲットゲーム

青いプレイヤーを動かして、黄色い的を集めよう。1個で1点！

十字キー：移動 ／ A・B：ダッシュ ／ START：開始・一時停止
SELECT（Tab・Backspace）：タイトルへ ／ Esc：操作枠から出る

ゲームを開始

STARTでスタート

ゲーム中はこの枠で入力を受け付けます。入力ログの記録は上の確認枠で行います。枠を離れると自動で一時停止します。
