otitbridge/snes-controller-uiapduino/docs/development/known-issues-history.md

> 開発記録：2026-11-10の文書整理前の内容を保存しています。試行時点の状態・作業指示を含みます。現在の利用手順は [資料の案内](../publication.md) を参照してください。

# 未確定事項と対応時期

2026-11-10のP4試験終了時点の状態です。試験ごとの合否は [検証一覧](validation-history.md)、途中の失敗・再試験・本人報告は [P4証跡](../evidence/p4-iphone-delta-2026-11-10.json) に保存しています。

| 項目 | 現状 | 確認する段階 |
| --- | --- | --- |
| 基板情報 | V1.4、電圧設定5V（初期状態）は本人申告済み。正式な製品型番・実測VDDは未確認 | P2の書き込み前／P3の配線前 |
| ビルド環境 | 専用 `.local/` にCLI 1.5.1、コア1.2.15、GCC 14.2.0-2を導入し、2種類の最小ファームをビルド済み | P2で確認済み。書き込み・実機動作は別途 |
| macOS依存ツール | x86_64版CLIとGCCがApple Siliconで実行でき、コンパイル・リンクに成功 | P2で確認済み。別OS・別Macは未試験 |
| パッケージの再現性 | コア・依存アーカイブ6個のSHA-256、配布ZIP全730ファイルと導入物、参照12ファイルのblobを照合済み | 次回導入時も検証スクリプトで照合 |
| FQBN | CLIの `board details` とビルドで、V1.4・48MHz・`usb=kbd` 等の設定を照合済み | P2で確認済み |
| Flashサイズ表示 | コアの集計式が `.init` を含まず、CLIは今回のBINより160バイト少なく表示する | BINとELFのセクションを併記済み。限界付近ではCLI表示だけに依存しない |
| 書き込み先・ブートローダ | `32V003`／`1209:B803`／記述子1.41の1台へ `uiapflash` で書き込み・読み戻し一致・アプリ起動に成功。RESETを押してUSBを接続し、直後に離して待機モードへ移行 | 全キー解放版と手動単キー版で確認済み。再書き込み時も対象を照合。ブートローダ全体の実物ハッシュは未測定 |
| 統合版の書き込み通信 | 初回は `0x08000540` でFeature Report受信に失敗。本人から、書き込み途中にUSBを抜き差ししたためとの申告あり。対象と同一BINを再照合した再試行では5,376バイトの全セクタ一致とアプリ起動に成功 | 通信失敗のログと本人申告を区別し、[統合版記録](../evidence/p3-sfc-keyboard-2026-11-10.json) に保持 |
| SFC基板と電源 | 既存版と同じ個体で、基板番号・線色・5信号の対応は本人申告済み。実配線と修正後に診断入力を確認。型番・基板版・実測VDD／VCCは未記録 | [wiring.md](wiring-history.md) の本人申告の対応表と5V構成に従う。写真・導通の元記録も未保存 |
| SFC信号ピン | SFC基板1=茶/GND、2=赤/DATA、3=橙/LATCH、4=黄/CLOCK、5=白/VCCとの本人申告。CLOCK=UIAP 7、LATCH=8、DATA=9で全12入力を確認 | 初回の無応答後、本人が配線の相違を修正。具体的な誤接続箇所は未記録 |
| USBバッファの整合性 | `sfc-keyboard` は専用コアの二重バッファと1バイト索引で完成状態だけを公開。ホストの割り込みモデルで147,456回の読取と、Macでの複数キー操作を確認。従来モードのコアは保持 | [パッチ](../../patches/README.md) を管理。転送完了・短押し保証は別途 |
| 短押し・復帰 | 公開ヘッダにキーボード転送完了や接続・復帰通知のAPIなし。最新状態の上書きだけでは過去の押下やニュートラル到達を保証できない。GBAでB単独・右保持中の短押し各10回の成功は本人報告済み | 今回の手操作はPASS。最小押下時間・高速入力の保証や復帰条件は別途確認 |
| 接続時の保持入力（U04） | 切り替え前のtrace v1はMac（Karabiner終了下）とiPhone Safariで保持成功、iPhone Deltaは押し直しが必要。原因未確定 | ユーザー裁定で未解決のまま許容し、解消を次工程の条件としない。全ボタンを離して接続。PASSとはしない |
| GET_REPORT(Input) | 元の `usb=kbd` は要求ルーティングが無効。専用コアの候補でキーボード8バイト／マウス4バイトの応答とEP0コピー保持を追加。通常・ASan／UBSanテスト、ビルドと書き込み・読み戻し検証に合格 | U04はこの対応だけでは解消しない。[管理パッチ](../../patches/README.md) とP4記録を参照 |
| USB割り込みとの共存 | SFC読み取りやデバッグ出力による波形・処理時間への影響は未測定 | P3。SFC読み取り全体の割り込み禁止は行わない |
| PCでのUSB列挙と単キー | 全解放版でキーボード（8バイト入力）とマウスを認識。手動版でも再認識し、Zキーの6.084秒・6.121秒・30.908秒の保持後の解放をブラウザで確認 | U01とMacの単キー試験はPASS。このP2試験はブラウザ観測。後のP4ではRaw HID取得済み、短押し保証は別途 |
| SFCキーボード実機操作 | 統合版で全12キー、左43.089秒・右36.649秒、部分解放、6→7→6入力の復帰5回をMacで確認 | この条件はPASS。最初の上限試験2回は所定の入力を維持した記録が揃わず、合格に含めない |
| ジャンパ線の短い入力 | 意図した3回の保持に先行して0.060秒・0.007秒の2回も記録。原因は未測定。デバウンスは未実装 | 短押しや接点の評価はP3／P4で別途実施 |
| MacでのRaw HID取得 | Karabiner終了後に非排他的な8バイト入力レポートの取得に成功し、Safariイベントと同時比較済み | OSコールバックの記録で、USB線上の全パケット取得ではない |
| 診断vendor HID | 未接続の1476フレームに続き、実配線修正後に全12入力、左39.056秒・右41.289秒、同時押し・部分解放を確認。修正後19,026＋右単独再試験7,232フレーム、不正0件 | 入力診断はPASS。現在のキーボード統合版とは別モード |
| 右保持時の斜め入力 | 最初の右保持では下も混入。本人は下側へ触れた可能性を報告。右単独の再試験は41.289秒、他入力なしで解放まで確認 | 再試験はPASS。初回の混入原因自体は未測定として記録 |
| 単独vendor HID設定 | `usb=webhid` はMacでUSBインターフェースが現れず。コアの記述子は宣言41／実データ34バイト。同梱の複合設定は両方84バイトで受信に成功 | コアは変更せず診断版を `usb=kbdweb` へ変更。原因の唯一性は未検証。初回の試行も記録 |
| iPhone／iPad・Delta | iPhone 17／iOS 26.2／Delta 1.7.3のGBA『シナモンふわふわ大作戦』で10入力登録・ゲームで使う操作、左右長押し・右＋Bの同時押しと部分解放、B短押し各10回、全解放状態でUSB再接続10回、USB-Cの向き4組、抜去中の右解放の成功を本人報告。U04は押し直しが必要。D08全解放3回・D09全解放3回・D10連続30分も本人報告でPASS。D09ロック中解放はFAIL。斜め・3入力以上とSNES全12入力の設定画面は本人確認済み。SNES実ゲームとiPadは未確認 | U04は本人同意で保留。iPhoneの操作時間は実測なし。ゲーム内未使用の操作とSNESのX・Yは分けて記録 |
| 内蔵後の状態 | 絶縁・固定・操作部との干渉・ケーブル応力・再書き込みアクセスは未試験 | P5はユーザー指示で保留（2026-11-10）。公開資料を先行整理 |

## 現在の基板と計測版

切り替え前の基板は `sfc-keyboard-trace` 初版（trace v1）、BIN 5,608バイト／静的RAM 204バイト、SHA-256 `e1c470d8a1e510b70e7984fb3f30742d05cc3fc9c7b959da5aba3af54df7e26d` です。該当BINを `.local/build/sfc-keyboard-trace-v1/` に保持しています。D08〜D10の後半試験はこの版で行いました。取得・書き込み監視プロセスは停止済みです。

`sfc-keyboard-trace` は履歴付きの計測版（trace v2）です。保存済みのBackspace版BINは5,968バイト／468バイト、SHA-256 `1fd1ed61cf74014beacef1cbd92d1d0a4b69313e9e304fc3aacee331ee2c28d6` で未書き込みです。SELECT→Tab変更後のtraceビルドは未実施のため、このハッシュを現在のソースの生成結果とは扱いません。SETUP ACK前の136バイト初期化・履歴コピーに応答時間上の懸念があり、修正・確認まで使用保留です。ホストテスト合格はUSB実時間の保証ではありません。

21:58に搭載した旧通常版は5,496バイト／196バイト、SHA-256 `e08cd59d66d77f36901c2e8a255cca5f2c89e8ddabcc4dc6fa95ab96c1d4937e` でした。現在は下記のSELECT→Tab対応版です。21:58に書き込み・5,504バイトの読み戻し一致・起動・MacのUSB/HID列挙を確認しました。通常版への切り替え後の操作確認は別途実施し、今回の合意範囲で完了しました。計測版の30分試験を通常版の実測結果へ転用しません。

## U04：接続時保持

最新のU04切り分け結果（通常版へ戻す前）: 計測版初版ではMac（Karabiner終了下）とiPhone Safariの接続時保持は成功し、iPhone Deltaでは押し直しが必要です。Delta公開ブランチ `v1.7.3` のDeltaCore参照コミット `373bf07b7da6630dec661e876a63d685d61b9f9c` を確認すると、iOS 26はGCKeyboardを使い、接続時にキー変化ハンドラーを登録します。[KeyboardGameControllerの初期化](https://github.com/rileytestut/DeltaCore/blob/373bf07b7da6630dec661e876a63d685d61b9f9c/DeltaCore/Game%20Controllers/Keyboard/KeyboardGameController.swift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)には、すでに保持中のキー状態を読み直す処理がありません。初期押下がハンドラー／受信側の準備前に発生する仮説と整合しますが、実アプリの通知順序とインストール済みバイナリは照合していないため、原因確定やDeltaの仕様とは断定しません。U04は未解決のままです。

MacではKarabiner稼働時の非排他的HID取得が `0xe00002c5` で失敗し、本人が終了した後は成功しました。同じtrace v1で接続時の右保持はHIDで12.228298秒、Safariで12.186秒続き、途中の解放はありませんでした。要求した20秒全体の実測ではありません。Karabiner再有効化の対照試験は未実施で、唯一の原因とは断定しません。

ユーザー裁定でU04は未解決のまま許容し、追加調査を次工程の条件から外します。接続時は全ボタンを離してください。旧ファーム／旧観測条件のSafari早期keyupは、現ファームのiPhone Safari比較では再現せず、履歴として保存しています。

## D09：ロック中の解放

全解放でのロック・解除3回は本人報告でPASS。右保持でロックし、ロック中に解放すると復帰後に右が残る条件はFAILです。他ボタンの操作中だけ右が止まり、解放後に戻るとの報告もありますが、そのボタンと順序は未記録です。Deltaを前面にして右を約1秒押し、完全に離すと回復し、その後も戻らないことを1件確認しました。USB抜き差し・RESETは不要でした。

D09ソース確認: Deltaの公開 `v1.7.3` ブランチが参照するDeltaCore `373bf07b7da6630dec661e876a63d685d61b9f9c` では、[解放処理](https://github.com/rileytestut/DeltaCore/blob/373bf07b7da6630dec661e876a63d685d61b9f9c/DeltaCore/Emulator%20Core/EmulatorCore.swift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)が、ゲーム画面にキーボードフォーカスがない場合、エミュレータへ解放を渡さず戻ります。一方、[コントローラー側の状態管理](https://github.com/rileytestut/DeltaCore/blob/373bf07b7da6630dec661e876a63d685d61b9f9c/DeltaCore/Model/GameControllerStateManager.swift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)では通知前に押下状態を消します。この条件で解放が届くと両者の状態が食い違い、前面へ戻って右を押し直して離すことで解消する経路があり、今回の報告と整合します。ただしロック中の実際のフォーカス値・コールバック・HIDレポートは未取得で、Delta原因の確定ではありません。D09はFAIL／未解決のまま、Delta側の処理を有力候補と記録します。ロック・アプリ切り替え前に全解放し、残留時はDelta前面で該当する右を押して離す運用とします（回復は今回1件で確認）。D10はその後30分連続使用に成功しましたが、このD09の解消判定には使いません。

最新のユーザー裁定でU04・D09は未解決のまま許容する方針となりました。以前の「Delta側の不具合なら」という条件を、進行の前提とはしません。原因未確定・FAILの記録は維持し、追加調査を次工程の条件から外します。ロック・アプリ切り替え前には全ボタンを離す運用とします。保持したまま解除まで待つ条件、電源継続・USB再列挙は未確認です。

## 継続使用と残る確認

D08全解放でのアプリ切り替え3回とD10の30分ちょうどの連続使用は本人報告でPASSです。D10はDelta前面・ロックなしの条件で、異常・警告なし。終了時の左・右・B確認も依頼しましたが回答に各操作の個別記述はなく、独立した時刻・USBログもありません。

Deltaの斜め・3入力以上は『シナモン』で本人確認済み、SNES全12入力は設定画面で本人確認済みです。6／7キーのDelta上の確認、SNES実ゲーム（ROM未所持で後日）、iPad、筐体内蔵後の試験が残っています。通常版の確認は今回の合意範囲で完了しました。D04の追加条件も未確認のままです。ゲーム内で観察できない操作を合格扱いにはしません。

## SELECTのDelta割り当て不応答：Tabへ変更して回避済み

旧通常版のSELECT→BackspaceはMacとiPhone Safariで押下・解放を確認できましたが、Deltaの割り当て画面で受け付けられませんでした。本人は以前からの可能性も指摘しており、通常版への切り替えで発生した退行とは断定しません。

追加の本人報告では、Deltaのキー配置画面でSELECTの割り当てにBackspaceが表示されていました。「割り当て表示が存在すること」と「実際のキー押下を現在の入力処理が受理すること」は分けて扱います。この表示だけでは、今回の環境でBackspaceの入力が過去に成功したことや、その割り当てが初期設定・保存済み設定のどちらに由来するかは確定できません。

公式履歴では、[2024年7月の変更](https://github.com/rileytestut/DeltaCore/commit/c7ee1f02855d1faf0fbab3c101ddd6211b7d8903)でMac向けにGCKeyboard方式を導入し、[2025年9月の変更](https://github.com/rileytestut/DeltaCore/commit/196afbcb03a0a06c9984b7d92a49049fcc2ff30a)で、従来方式が動かないiOS 26でも新方式を使用するようにしています。Delta 1.7.3が参照するコードでは、新方式のBackspaceに明示的な対応がなく、その他のキーを受ける既定分岐も説明文字列の先頭要素が1文字の場合に限ります。Tabは明示対応しています。

このため、Backspaceを意図的に禁止する元来の仕様という説明よりも、iOS 26で新方式へ切り替わったことで対応漏れが表面化した可能性を有力な仮説とします。ただし実行時のキー情報・分岐は未取得で、旧OS／旧Deltaとの比較試験も行っていません。原因確定、直近の更新による退行、公式に認定された不具合とは記載しません。今回のSafariでの正常入力とTabへの変更による解消は、この仮説と整合する観測結果です。

Delta 1.7.3対応の [KeyboardGameController](https://github.com/rileytestut/DeltaCore/blob/373bf07b7da6630dec661e876a63d685d61b9f9c/DeltaCore/Game%20Controllers/Keyboard/KeyboardGameController.swift) にはBackspaceの明示的な分岐がなく、Tabは明示対応しています。SELECTだけをTab（`0x2B`）へ変更し、通常・ASan／UBSanのホスト試験とMCUビルドに合格しました。旧BINとの差はオフセット4,750の1バイト（`0x2A`→`0x2B`）だけです。

現在の基板は22:19に書き込んだTab対応通常版、5,496バイト／静的RAM 196バイト、SHA-256 `43a82eb36c7df4d298dd01f6b25460117fab0207c9206382b5eeaf92379a9079` です。5,504バイトの全セクタ読み戻し一致・起動・Mac再列挙、MacのTab押下・解放3回とBの対照を確認しました。本人もDeltaでTabとして登録でき、『シナモン』の動作に問題なしと確認しました。この環境のSELECT不応答は回避済みです。正確な内部原因を確定する結果ではありません。

GBA以外のキーレイアウトでもSELECTはTabへ設定してください。過去のSNES全12入力確認報告は旧版の履歴であり、新しいTab割り当ての確認とは区別します。Tab通常版の同時押し・部分解放・再接続3回の仕上げ確認も本人報告でPASSです。動作確認済みのTab設定を維持します。[SELECT対処の証跡](../evidence/p4-select-tab-2026-11-10.json) を参照してください。

## 内蔵工程の保留と公開資料

2026-11-10、ユーザーの指示でP5（筐体への内蔵・組立後試験）を保留し、P6の公開用資料整理を先行しました。内蔵の固定・絶縁・加工仕様、配線／内部写真は未収録です。現時点の部品・配線・導入手順と既知制約を公開対象とし、未実施事項はそのまま明示します。[公開資料の範囲](../publication.md) を参照してください。
