otitbridge/snes-controller-uiapduino/docs/development/sfc-keyboard-history.md

> 開発記録：2026-11-10の文書整理前の内容を保存しています。試行時点の状態・作業指示を含みます。現在の利用手順は [資料の案内](../publication.md) を参照してください。

# SFC入力からUSBキーボード出力への統合

実配線後の全12入力・長押し・部分解放の診断を終え、`sfc-keyboard` モードを追加しました。
確認済みのCLOCK＝UIAP 7、LATCH＝8、DATA＝9と、5V電源／GNDの配線を使用します。
[配線表](wiring-history.md) を参照してください。配線変更はUSBを外して行います。

## ビルド

現在のソースはSELECT→Tabの通常版です。22:19に搭載し、MacでTab押下・解放、DeltaでTab登録と『シナモン』の正常動作を確認しました。DeltaのSELECTはTabへ再割り当てしてください。旧Backspace版のMac回帰試験とは区別します。[証跡](../evidence/p4-select-tab-2026-11-10.json) を参照してください。

```sh
bash scripts/build_firmware.sh sfc-keyboard
```

コアは `UIAP_HID:ch32v@1.2.15` を元に、[共有状態とGET_REPORT(Input)応答のパッチ](../../patches/README.md) を専用コピーへ
適用します。既存の導入済みコアは保持します。USBは `usb=kbd`（Keyboard+Mouse）で、マウスは操作しません。
P4のGET_REPORT応答を加えた検証候補はBIN 5,496バイト、静的RAM 196バイトです。
CLIのFlash表示5,336バイトに `.init` 160バイトを加えた値がBINと一致します。
以下のP3実機結果は変更前のBIN 5,360バイト、静的RAM 188バイトでの記録です。

生成先は `.local/build/sfc-keyboard/`、使用するCLI設定は `.local/sfc-arduino-cli.yaml` です。
SFCキーボード用フラグは `SNES_SFC_KEYBOARD=1`、他の入力モードは0です。
未変更コアでのこのモード、診断との同時指定、単キー試験との同時指定はコンパイルで拒否します。

起動前に全解放を設定し、約10msごとに現在のSFC状態を読み、[引き継ぎ仕様のキー表](../../SNES_UIAPduino_CODEX_HANDOFF.md#6-入力仕様キー割り当て)
へ変換します。下位bit順の先頭6キーだけを採用し、7キーから6キーへ戻ると保持中のキーを再計算します。
SFC読取中も、キーボード状態の公開中も、USB割り込みを禁止しません。

## 検査済みの範囲

- 実際のスケッチ・SFC読取・USBバックエンドをホスト上で接続し、全4,096通りの入力、保持、部分解放、6キー上限からの復帰を確認。
- 実際のコアのsetterとUSB読取を使った割り込みモデルで、元コアの混在を再現し、変更後は147,456回の挿入点で完全な旧状態または新状態だけを確認。clearと反復保持も対象。
- 上記を通常構成とAddressSanitizer／UndefinedBehaviorSanitizerの両方で確認。
- RISC-Vの生成コードで8バイトの書込後に1バイトの公開索引をstoreし、USB側は索引を1回loadして送信することを確認。
- 従来の `neutral`、`manual`、`sfc-diagnostic` は、実機確認済みのBINとハッシュが一致。

これらはビルド・ホスト検査です。統合版の書き込みとMacでのキー操作は次節に分けて記録します。
最新の実施状態は [検証結果](validation-history.md) と [統合版の記録](../evidence/p3-sfc-keyboard-2026-11-10.json) を参照してください。

## 書き込みとMac試験の結果

2026-11-10、`32V003`／`1209:B803`／記述子 `0x0141` の1台とBIN・ツールのハッシュを照合して書き込みました。
初回は `0x08000540` でFeature Reportの受信に失敗しました。後から本人より、書き込み中にUSBを抜き差ししたためとの申告があり、通信失敗のログと分けて記録しました。
同じ対象とBINで再試行し、5,376バイトの全セクタ読み戻し一致とアプリ起動に成功しました。ブートローダ領域は書き換えていません。

この書き込み時点では `sfc-keyboard` がMacにKeyboard+Mouseとして認識されました。現在のP4検証候補は末尾に記載します。
Safari 27.0の試験画面で、本人がSFCだけを操作し、次を確認しました。

| 操作 | 観測した結果 |
| --- | --- |
| 全12ボタンを単独操作 | 指定された12キーの押下・解放が順に届き、各回全解放 |
| 左右の保持・解放 | 左43.089秒、右36.649秒。保持中断・他キー混入なし |
| 右＋Y＋BからBだけ解放 | 3キーを7.576秒保持した後、右＋Yが6.188秒残り、最後は全解放 |
| B＋Y＋SELECT＋START＋L＋Rに上方向を追加・解放 | 7入力時にR→Wが外れ、上を離すとR→Wが復帰。5回確認し、最後は全解放 |

最初の2回の上限試験では、所定の6入力を維持できた記録が揃わず、7入力からの復帰判定には使っていません。
上表の最後の組み合わせへ変更した再試験で確認しました。手操作とデバイス動作のどちらが最初の崩れの原因かは独立に測定していません。
合格に使った操作区間にフォーカス喪失はありません。これらはブラウザのイベントで、Raw HIDレポートではありません。

## Macでのキー操作確認

書き込みは [build.md](build-history.md#usb契約と確認済みの書き込み方法) の対象確認を行い、
`.local/build/sfc-keyboard/snes_controller.ino.bin` を使用します。USBを抜き、RESETを押しながらMacへ接続し、
接続直後にRESETを離して書き込みモードへ入ります。SFCの全ボタンを離して操作します。

Mac内だけで動く記録画面を起動します。ログ名は毎回新しい名前にします。

```sh
python3 scripts/serve_keyboard_probe.py sfc-keyboard-trial.jsonl
```

表示された `http://127.0.0.1:ポート番号` をSafariで開き、「記録を消して開始」をクリックします。
SFCだけを操作し、パソコンのキーは押さず、画面を前面に保ちます。フォーカスが外れた区間の保持は合格に含めません。
サーバーはこのページの12キーとフォーカス状態だけを `.local/logs/` へ保存します。
記録はブラウザのキーイベントで、USBレポートのバイト列や入力元デバイスの識別ではありません。
SFCを操作したことは本人の手順・申告と対応づけます。

1. 全12ボタンを1個ずつ押し、各キーが解放へ戻ることを確認。
2. 左右を各30秒以上保持し、途中で切れず、離すと止まることを確認。
3. 右＋Y＋Bを保持し、Bだけを離して右＋Yが残り、その後全解放することを確認。
4. B＋Y＋SELECT＋START＋L＋Rの6入力を保持し、上方向を追加する。7入力時はR→Wが外れ、上を離すとWが復帰することを確認。

## 残る制限

共有状態パッチは完全な最新状態を公開します。GET_REPORT応答パッチもsetterの契約を変えません。setterはvoidのままで、ホスト受信、転送完了、
ゲームでの反映を保証する戻り値はありません。短押しの保持、再接続・スリープ通知、
起動時のニュートラル到達も保証しません。これらは個別に実機確認します。
vendor HIDのSFC診断版と、キーボード出力のこのモードは別ビルドです。

## iPhone／Deltaの現在の結果

iPhone 17／iOS 26.2／Delta 1.7.3、GBA『シナモンふわふわ大作戦』、既存M5StickS3版と同じUSB-Cケーブルで試験しました。初期試験はP3版、後半は計測版初版（trace v1）です。現在の基板は通常版 `sfc-keyboard` へ切り替え済みで、切り替え後の操作試験は末尾に記す今回の合意範囲で完了しました。

| 条件 | 判定・範囲 |
| --- | --- |
| GBA 10入力登録・ゲームで使う操作、左右保持、右＋Bと部分解放、短押し各10回 | 本人報告でPASS。ゲーム内未使用操作の内訳は未申告 |
| 全解放でのUSB再接続10回・USB-C方向4組・抜去中の右解放 | 本人報告でPASS |
| D08 アプリ切り替え／D09 ロック解除（全解放） | trace v1で各3回、本人報告でPASS |
| D03 斜め・3入力以上 | 『シナモン』で本人確認済み。具体的な組み合わせと最大数は未申告 |
| D01 SNES全12入力 | キーレイアウト設定画面で本人確認済み。ROM未所持で実ゲームは未確認 |
| D10 連続使用 | trace v1で30分ちょうど、異常・警告なし。Delta前面・ロックなし |
| U04 接続前から保持した右 | Deltaでは押し直しが必要。ユーザー裁定で未解決のまま許容し、次工程へ進む |
| D09 ロック中に右を解放 | 復帰後に右が残るためFAIL。右の押し直し・解放で回復。ユーザー裁定で未解決のまま許容 |

切り替え前のtrace v1の接続時保持はMac（Karabiner終了下、HID観測12.228298秒）とiPhone Safariでは成功しました。Delta側処理が原因の候補ですが、U04・D09とも実行時の原因は確定していません。全解放で接続し、ロック・アプリ切り替えの前にも全ボタンを離す運用です。

trace v1のBIN SHA-256は `e1c470d8a1e510b70e7984fb3f30742d05cc3fc9c7b959da5aba3af54df7e26d`。現在のtraceビルドで生成される履歴付き版（trace v2）は未書き込みで、SETUP応答時間の懸念が解決するまで使用保留です。通常版への切り替え後の試験は、このtrace v1の結果と分けて末尾に記録しています。

各試験の識別情報・旧版での失敗・再試験は [P4証跡](../evidence/p4-iphone-delta-2026-11-10.json)、観測方法と限界は [検証結果](validation-history.md)、原因の仮説と残件は [未確定事項](known-issues-history.md) を参照してください。Deltaの6／7キー、D04の追加条件、SNES実ゲーム（後日）、iPadと内蔵後の試験は残っています。U04・D09の追加原因調査は次工程の前提としません。

## 通常版への切り替え（21:58）

2026-11-10、通常版 `sfc-keyboard`（BIN 5,496バイト、SHA-256 `e08cd59d66d77f36901c2e8a255cca5f2c89e8ddabcc4dc6fa95ab96c1d4937e`）を1台の確認済みブートローダへ書き込みました。5,504バイトの全セクタ読み戻し一致とアプリ起動を確認し、同じUSB位置で `1209:D004`、キーボード8バイト／マウス4バイトのHIDとして再認識しました。計測フラグは無効です。書き込み監視は正常終了しました。

この書き込み記録が示すのは切り替え・列挙の成功です。後続の操作確認の結果は以下に分けて記録します。[書き込み証跡](../evidence/p4-final-normal-upload-2026-11-10.json) に記録しています。

SELECT対処のDelta確認: 本人から「認識されました　タブキーでした　シナモンでの動作も問題ないです」と報告を得ました。現在のTab対応版でGBAのSELECT割り当てと報告されたゲーム動作はPASSです。Backspace不受理の実行時原因を断定せず、Tabへの変更で回避できたと記録します。別システムの設定ではSELECTをTabへ設定する必要があります。続く同時押し・部分解放・再接続の仕上げ結果は次段落に記録します。

通常版の仕上げ確認完了: SELECT→Tab版で、斜め・3入力以上の同時押しと、右＋BからBだけを離して右を維持し全解放する操作について、本人から「2点とも問題無しです」と報告を得ました。続いて全解放でのiPhone再接続、左・右・B・SELECTの操作・解放を再割り当てなしで確認する手順に対し、「再接続 3回も問題無しです」と報告があり、3回PASSとしました。実時間・個別イベントの独立計測はありません。これで工程2の通常版確認は今回の合意範囲で完了です。Mac全項目は先行Backspace版、Tab版はSELECT/Bの対象試験と今回のiPhone試験であり、30分試験の再実施ではありません。U04・D09は未解決のまま許容、Deltaの6／7入力・SNES実ゲーム・iPadは別の未確認範囲として残し、次はP5の筐体内蔵と組立後試験です。
