otitbridge/snes-controller-uiapduino/(commit log)

2026-11-10 feat: add SFC input diagnostics and wiring documentation
2026-11-10 test: record wired SFC button holds and partial release
2026-11-10 fix: map SELECT to Tab and record normal firmware validation
    [snes_hid_report.h]
2026-11-10 docs: prepare public guides and defer enclosure integration
2026-11-10 docs: add hardware diagram, board price and validation status
2026-11-11 docs: record enclosure installation and post-assembly checks
2026-11-11 docs: record Delta issue, iPad validation and enclosure stability
2026-11-11 docs: reconcile guides and add enclosure photos
2026-11-11 feat: publish SFC-style keyboard probe on GitHub Pages
2026-11-11 docs: record public probe validation on Mac iPhone and iPad
2026-11-11 docs: record USB direct wiring and alternative CH32 boards
2026-11-11 docs: record Seria EM-69A cable validation
2026-11-13 fix: support Backspace SELECT in keyboard probe
2026-11-13 feat: add 30-second target game to keyboard probe
